brucejcooper/TinyModbus/pcb/TinyModbus.png

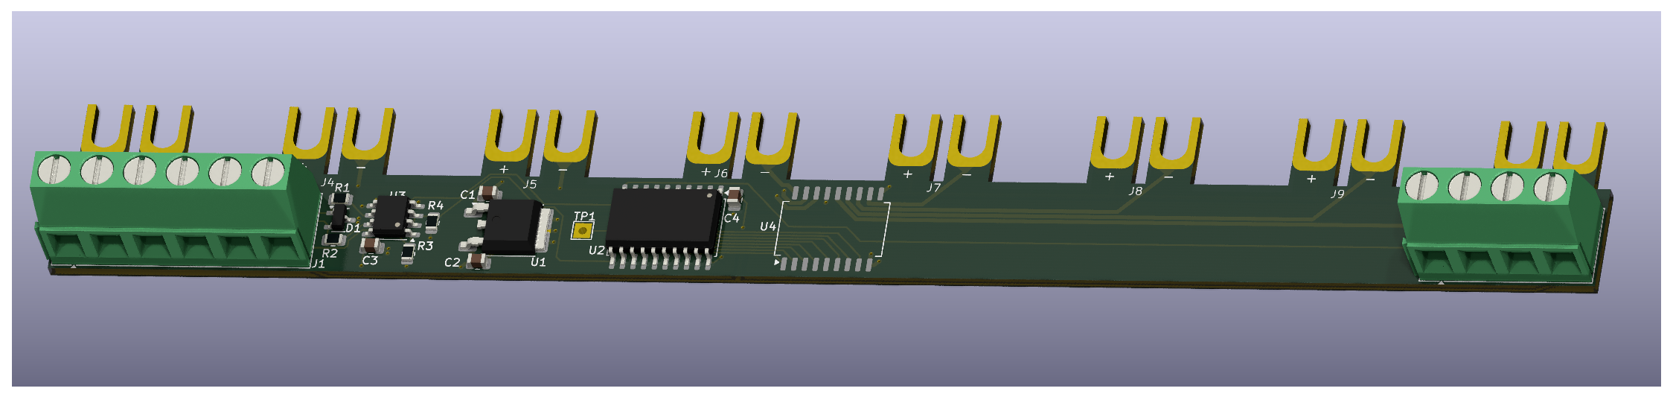
pcb/TinyModbus.png
