brucejcooper/TinyModbus/pcb/MikroeAdapter/MikroeAdapter.kicad_pcb

## KiCad design pcb/MikroeAdapter/MikroeAdapter.kicad_pcb (2026-07-29)

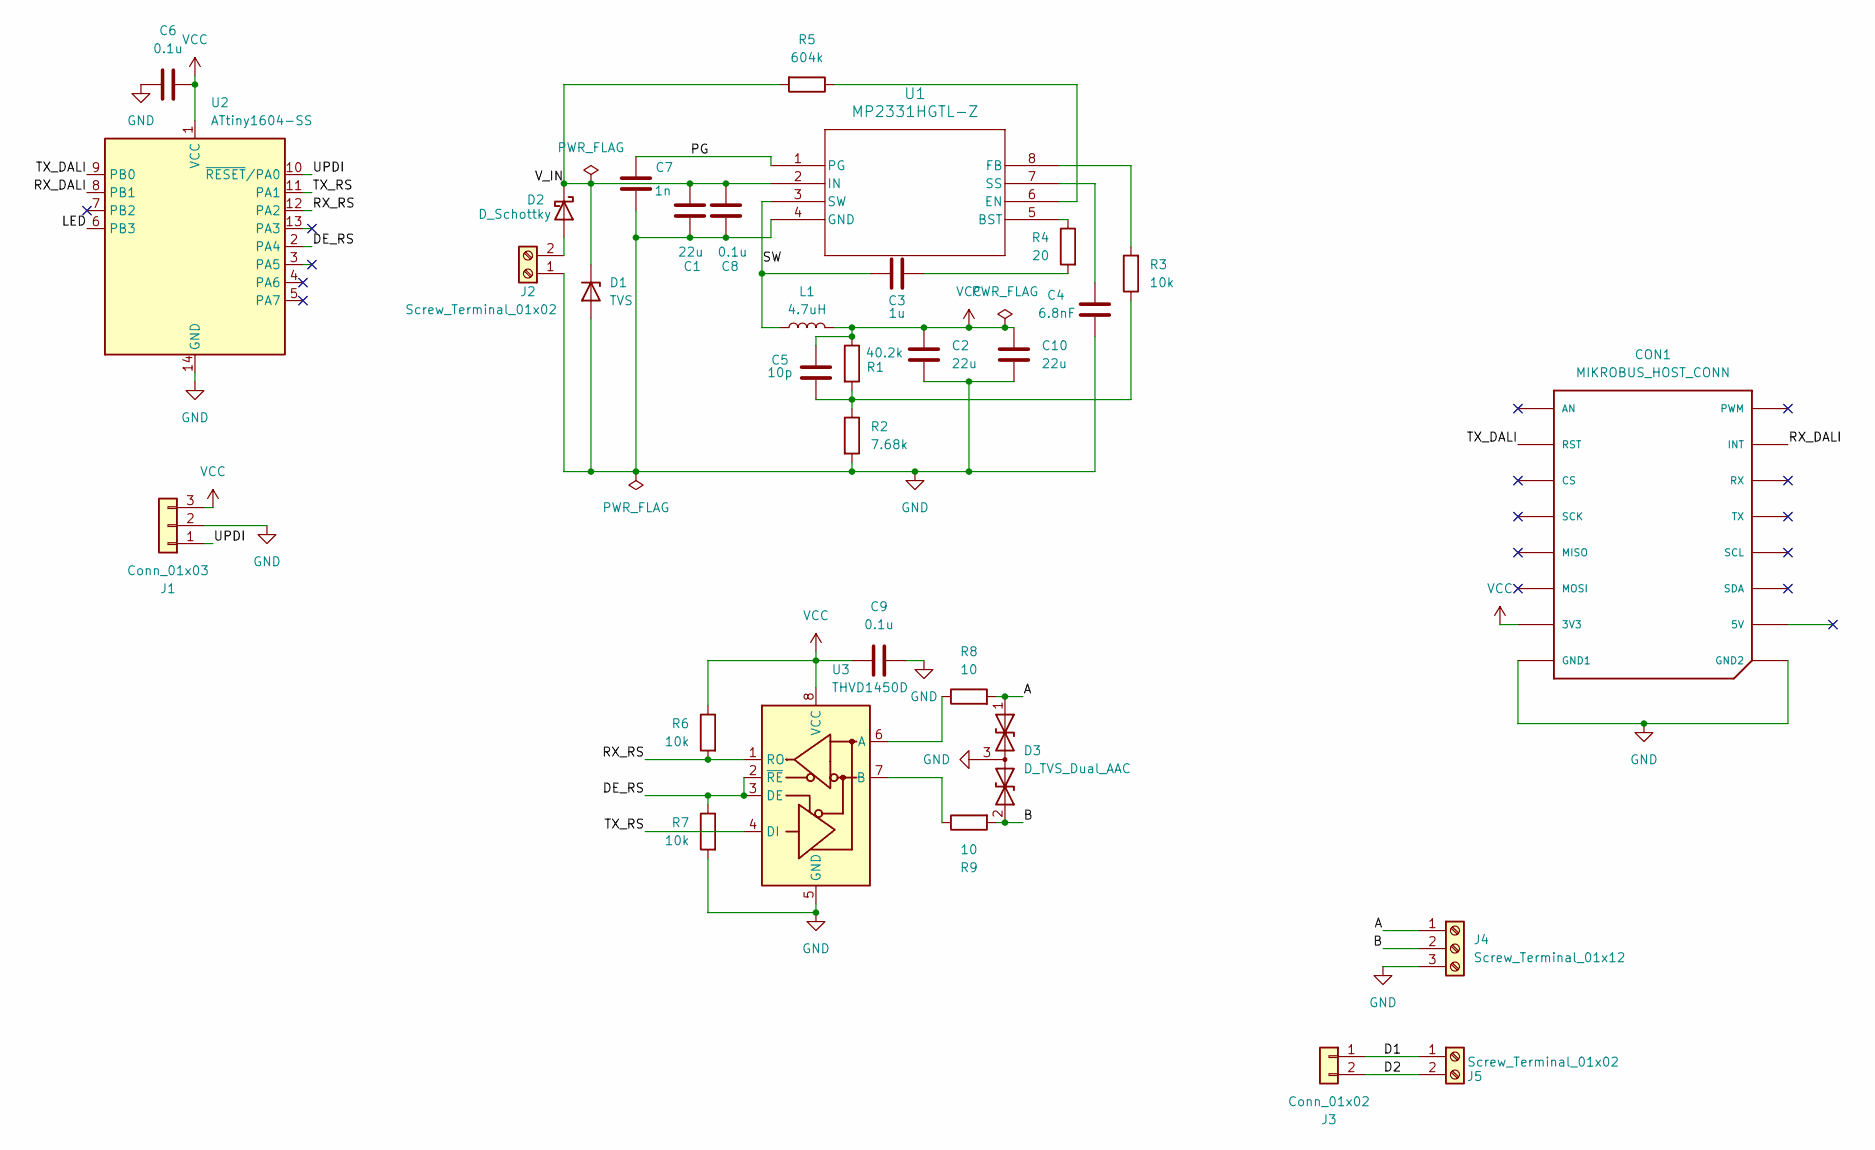
[picture p3: schematic MikroeAdapter.kicad_sch]

Parts:
C1, C2, C10: 22u; C_1210_3225Metric
C3: 1u; C_0603_1608Metric
C4: 6.8nF; C_0603_1608Metric
C5: 10p; C_0402_1005Metric
C6, C8, C9: 0.1u; C_0402_1005Metric
C7: 1n; C_0402_1005Metric
CON1: MIKROBUS_HOST_CONN
D1: TVS; D_SMB
D2: D_Schottky; D_SMA
D3: D_TVS_Dual_AAC; SOT-23
J1: Conn_01x03; PinHeader_1x03_P2.54mm_Vertical
J2, J5: Screw_Terminal_01x02; TerminalBlock_Phoenix_MKDS-1,5-2-5.08_1x02_P5.08mm_Horizont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
J3: Conn_01x02; PinHeader_1x02_P2.54mm_Vertical
J4: Screw_Terminal_01x12; TerminalBlock_Phoenix_MKDS-1,5-3-5.08_1x03_P5.08mm_Horizont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
L1: 4.7uH; IND-SMD_L4.0-W4.0_FNR40XXS
R1: 40.2k; R_0402_1005Metric
R2: 7.68k; R_0402_1005Metric
R3: 10k; R_0402_1005Metric
R4: 20; R_0402_1005Metric
R5: 604k; R_0402_1005Metric
R6, R7: 10k; R_0805_2012Metric
R8, R9: 10; R_0603_1608Metric
U1: MP2331HGTL-Z; SOT-583-8
U2: ATtiny1604-SS; SOIC-14_3.9x8.7mm_P1.27mm
U3: THVD1450D; SOIC-8_3.9x4.9mm_P1.27mm

Connections:
/A: D3.1 (A1), J4.1, R8.2
/B: D3.2 (A2), J4.2, R9.2
/D1: J3.1, J5.1
/D2: J3.2, J5.2
/DE_RS: R7.1, U2.2 (PA4), U3.2 (~RE), U3.3 (DE)
/LED: U2.6 (PB3)
/PG: C7.1, U1.1 (PG)
/RX_DALI: CON1.P15 (INT), U2.8 (PB1)
/RX_RS: R6.2, U2.12 (PA2), U3.1 (RO)
/SW: C3.2, L1.1, U1.3 (SW)
/TX_DALI: CON1.P2 (RST), U2.9 (PB0)
/TX_RS: U2.11 (PA1), U3.4 (DI)
/UPDI: J1.1, U2.10 (~RESET/PA0)
/V_IN: C1.1, C8.1, D1.1 (K), D2.1 (K), R5.2, U1.2 (IN)
GND: C1.2, C2.2, C4.1, C6.1, C7.2, C8.2, C9.1, C10.2, CON1.P8 (GND1), CON1.P9 (GND2), D1.2 (A), D3.3 (common), J1.2, J2.1, J4.3, R2.2, R7.2, U1.4 (GND), U2.14 (GND), U3.5 (GND)
unnamed: C3.1, R4.2
unnamed: C5.2, R1.2, R2.1, R3.1
unnamed: D2.2 (A), J2.2
unnamed: R4.1, U1.5 (BST)
unnamed: R5.1, U1.6 (EN)
unnamed: R3.2, U1.8 (FB)
unnamed: C4.2, U1.7 (SS)
unnamed: R8.1, U3.6 (A)
unnamed: R9.1, U3.7 (B)
VCC: C2.1, C5.1, C6.2, C9.2, C10.1, CON1.P7 (3V3), J1.3, L1.2, R1.1, R6.1, U2.1 (VCC), U3.8 (VCC)

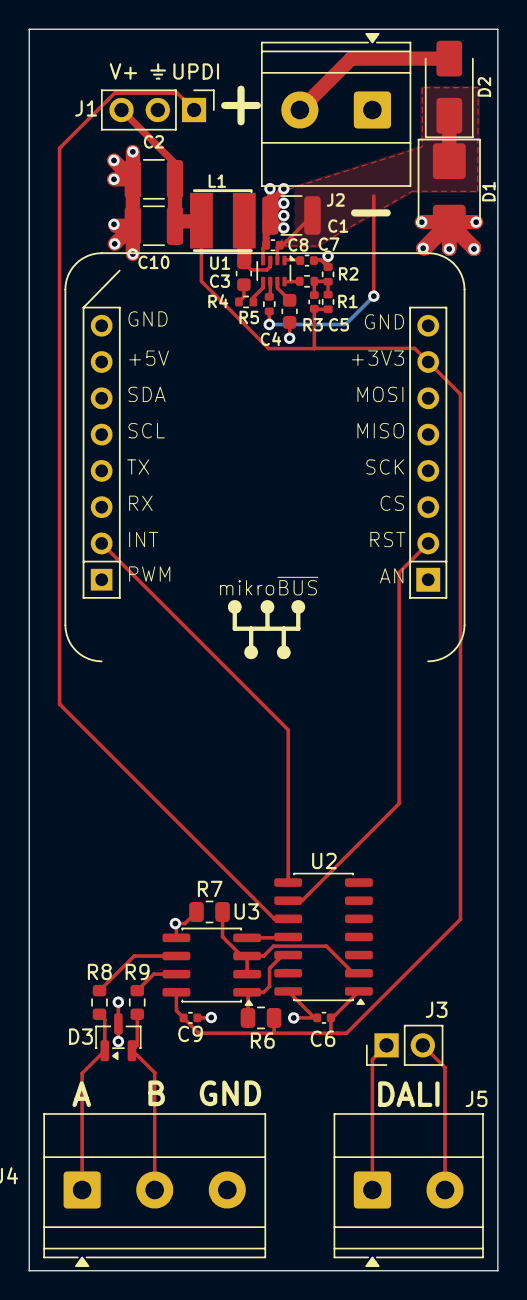
[picture p4: board MikroeAdapter.kicad_pcb from above]

Board: 2 copper layers, 32.8 x 86.9 mm, 32 parts (0 on the bottom side), 24 nets.
