brucejcooper/TinyModbus/pcb/TinyModbus.kicad_pcb

## KiCad design pcb/TinyModbus.kicad_pcb (2025-05-31)

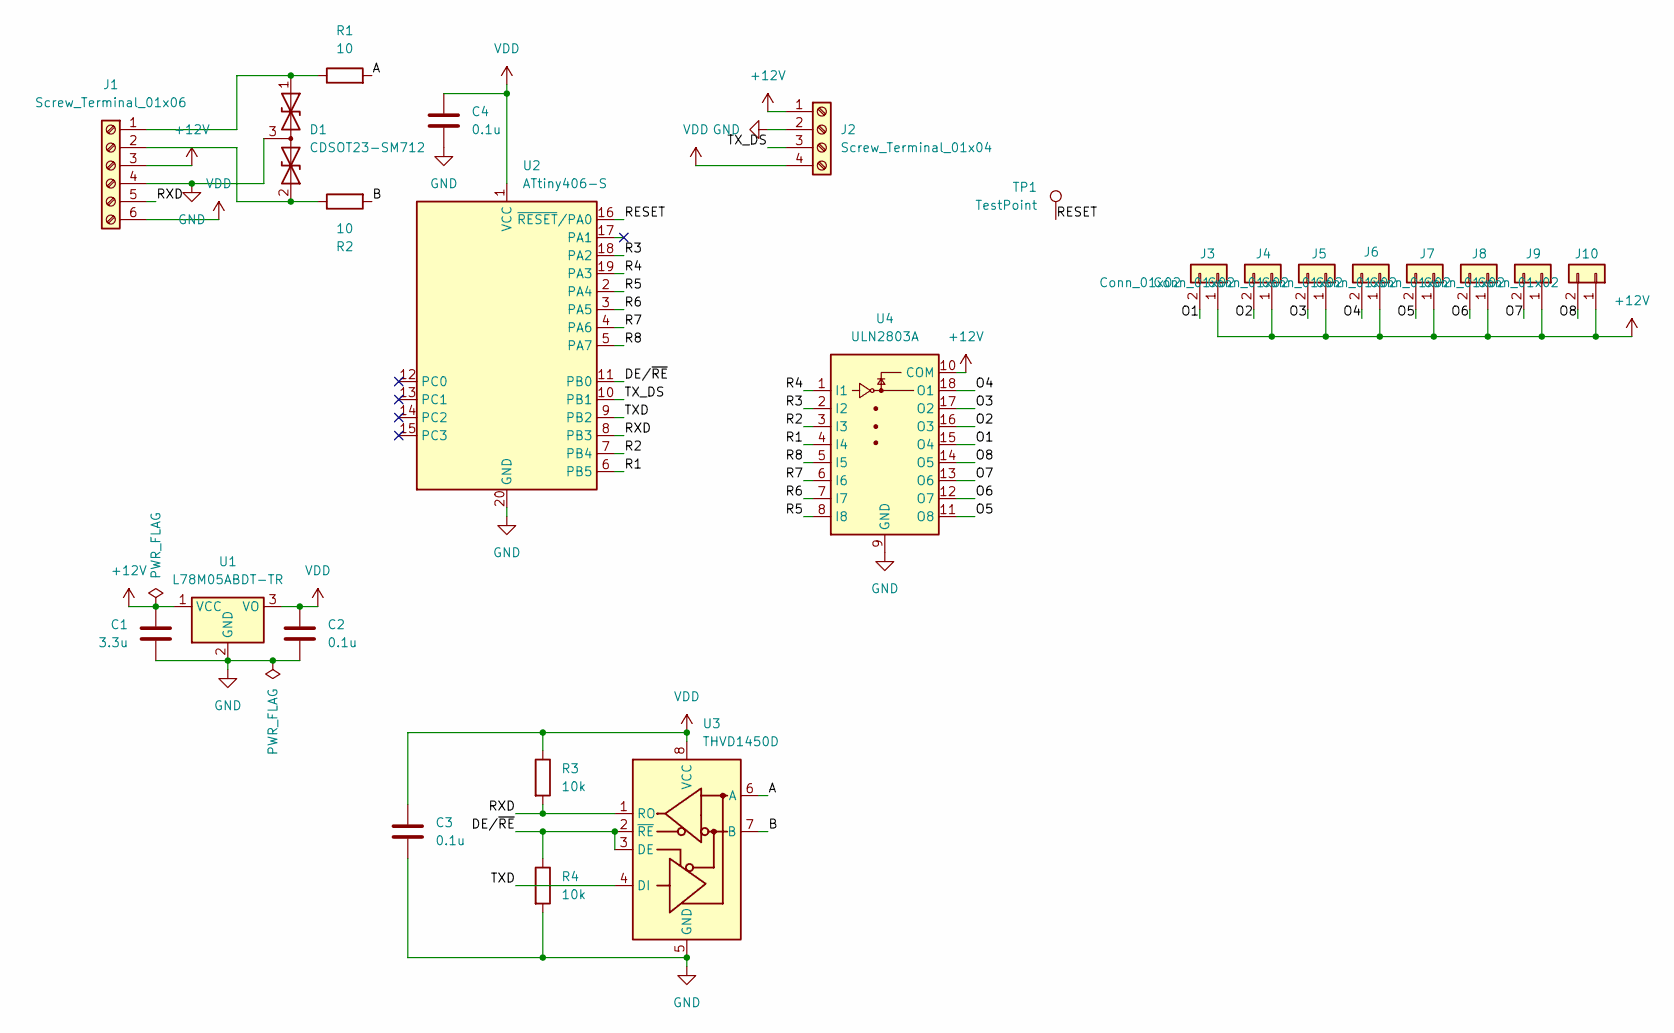
[picture p5: schematic TinyModbus.kicad_sch]

Parts:
C1: 3.3u; C_0805_2012Metric
C2, C3, C4: 0.1u; C_0805_2012Metric
D1: CDSOT23-SM712; SOT-23-3
J1: Screw_Terminal_01x06; TerminalBlock_Phoenix_MKDS-1,5-6-5.08_1x06_P5.08mm_Horizont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
J2: Screw_Terminal_01x04; TerminalBlock_Phoenix_MKDS-1,5-4-5.08_1x04_P5.08mm_Horizont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
J3, J4, J5, J6, J7, J8, J9, J10: Conn_01x02; Terminal_lug
R1, R2: 10; R_0805_2012Metric
R3, R4: 10k; R_0805_2012Metric
TP1: TestPoint; TestPoint_THTPad_2.0x2.0mm_Drill1.0mm
U1: L78M05ABDT-TR; TO-252-2
U2: ATtiny406-S; SOIC-20W_7.5x12.8mm_P1.27mm
U3: THVD1450D; SOIC-8_3.9x4.9mm_P1.27mm
U4: ULN2803A; SOP-18_7x12.5mm_P1.27mm

Connections:
+12V: C1.1, J1.3, J2.1, J3.1, J4.1, J5.1, J6.1, J7.1, J8.1, J9.1, J10.1, U1.1 (VCC), U4.10 (COM)
/A: R1.2, U3.6 (A)
/B: R2.2, U3.7 (B)
/DE/~RE: R4.1, U2.11 (PB0), U3.2 (~RE), U3.3 (DE)
/O1: J3.2, U4.15 (O4)
/O2: J4.2, U4.16 (O3)
/O3: J5.2, U4.17 (O2)
/O4: J6.2, U4.18 (O1)
/O5: J7.2, U4.11 (O8)
/O6: J8.2, U4.12 (O7)
/O7: J9.2, U4.13 (O6)
/O8: J10.2, U4.14 (O5)
/R1: U2.6 (PB5), U4.4 (I4)
/R2: U2.7 (PB4), U4.3 (I3)
/R3: U2.18 (PA2), U4.2 (I2)
/R4: U2.19 (PA3), U4.1 (I1)
/R5: U2.2 (PA4), U4.8 (I8)
/R6: U2.3 (PA5), U4.7 (I7)
/R7: U2.4 (PA6), U4.6 (I6)
/R8: U2.5 (PA7), U4.5 (I5)
/RESET: TP1.1, U2.16 (~RESET/PA0)
/RXD: J1.5, R3.2, U2.8 (PB3), U3.1 (RO)
/TXD: U2.9 (PB2), U3.4 (DI)
/TX_DS: J2.3, U2.10 (PB1)
GND: C1.2, C2.2, C3.2, C4.2, D1.3 (common), J1.4, J2.2, R4.2, U1.2 (GND), U2.20 (GND), U3.5 (GND), U4.9 (GND)
unnamed: D1.1 (A1), J1.1, R1.1
unnamed: D1.2 (A2), J1.2, R2.1
VDD: C2.1, C3.1, C4.1, J1.6, J2.4, R3.1, U1.3 (VO), U2.1 (VCC), U3.8 (VCC)

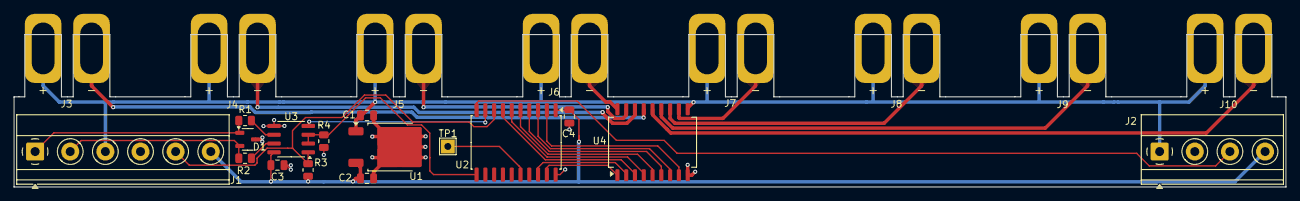
[picture p6: board TinyModbus.kicad_pcb from above]

Board: 2 copper layers, 183.9 x 22.0 mm, 24 parts (0 on the bottom side), 28 nets.
