brucejcooper/TinyModbus/src/relays.h

#ifndef __relays_H__
#define __relays_H__

#include <stdint.h>

extern void relay_init();
extern void latchOutputs();
extern void setCoil(uint8_t addr, uint8_t val);
extern uint8_t getCoils(uint8_t addr);


#endif
