brucejcooper/TinyModbus/(commit log)

2025-05-31 Added picutre of PCB
2025-10-10 Switching the name of the base to DTF08a
2025-10-15 Many bug fixes, but it now accepts DALI commands directly, as used by the web configuration device
2025-10-20 Switch to Production (hahardware, and using tick based timer, instead of trying software bollocks
2025-11-03 Fixed ISR bug, and changed web client to use entity editors, rather than just device editors that made assumptions about the entities contained
2026-04-19 Rewrite firmware with non-blocking DALI/Modbus architecture
    Replaces the synchronous rs485/timers/queue/dali_commands modules with a
    cleaner non-blocking design: a 16-entry command queue (cmd_queue), a
    dedicated register map (registers), unified tick dispatch (tick), and a
    new modbus module. FC44 retains its synchronous busy-wait behaviour for
    backwards compatibility. Also fixes the avr-gcc 7.3.0 toolchain bug where
    crtattiny1604.o defines __DATA_REGION_LENGTH__=0x400 (1KB) instead of the
    correct 0x800 (2KB), causing spurious linker overflow errors.
2026-04-19 Reduce static RAM to fit within ATtiny1604's 1KB SRAM
    - Pack cmd_type_t and reg_target_t enums (__attribute__((packed))) so each
    field is 1 byte instead of 2, saving 32 bytes in the 8-entry command queue
    - Shrink CMD_QUEUE_SIZE from 16 to 8 entries (saves 80 bytes)
    - Reduce Modbus frame buf from 136 to 72 bytes; caps FC03/FC04 reads to
    32 registers per request
    - Eliminate static ver_str[64]: version string is now built on-demand
    into buf in process_fc04 (full 32-register read only, addr 0x0200)
    - Revert erroneous __DATA_REGION_LENGTH__=0x800 Makefile workaround;
    the 1KB spec is correct for this device
    Result: Data drops from 1101 bytes to 877 bytes, leaving 147 bytes of
    headroom for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
2026-04-19 Fix DALI state machine double-dispatch and missing bus-idle wait
    cmdq_result_received() was calling dali_idle_state_enter() unconditionally,
    which started the next TX immediately. Callers then made conflicting second
    calls: timeout_waiting_for_response called dali_idle_state_enter() again
    (double-dispatch), while timer_overflow and send_rx_error called
    dali_wait_for_idle_state_enter() which overwrote the timer and undid the
    dispatch.
    Fix: cmdq_result_received() is now the single authority for post-command
    state transitions. When more commands remain it calls
    dali_wait_for_idle_state_enter() to enforce the required 22 TE bus-settling
    period before the next forward frame. When the queue empti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
2026-04-19 Add async raw DALI command registers and DTR write registers
    Register map changes:
    - 0x1000: raw DALI single send — sets FC04 0x015D to pending (0xFF00),
    result filled by callback: 0x02xx=ok, 0x01xx=nak, 0x03xx=err
    - 0x1001: raw DALI send-twice — same pending/result mechanism, NAK=normal
    - 0x1002: DAPC (shifted from 0x1001)
    - 0x1003-0x100A: action regs (shifted from 0x1002-0x1009)
    - 0x100B/0x100C/0x100D: set DTR0/DTR1/DTR2 (low byte = DTR value)
    - Writing 0x1000/0x1001 while a command is pending returns DEVICE_BUSY (0x06)
2026-04-19 Fix raw DALI command comment: two frame bytes, not addr+cmd
2026-04-19 Fix scanner queue overflow: chain per-ballast queries one at a time via callbacks
    Replaces the bulk 9-command push (which exceeded CMD_QUEUE_SIZE=8) with a
    chained callback pattern: scan_next_query pushes exactly one query per
    invocation, using a PROGMEM table and scan_query_step counter. This also
    allows the fade poller to interleave between scan commands.
2026-04-19 Replace timer-based fade poll with reactive per-ballast callback chain
    The old design fired a periodic timer and pushed 2 commands per fading
    ballast all at once, overflowing the 8-entry queue with many concurrent
    faders.
    New design: bgtasks_start_fade_poll() starts a self-sustaining
    STATUS → BRIGHTNESS → STATUS chain per ballast, guarded by a
    fade_chain_active[] bitmask to prevent duplicates. The chain pushes
    at most 2 commands at a time and terminates automatically when
    FADE_RUNNING clears.
    modbus.c calls bgtasks_start_fade_poll() for short-address DAPC and
    action commands instead of speculatively writing g_regs.fading[]. The
    fading[] register is now maintained solely by regs_apply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
2026-04-19 Remove diagnostic PB3/PA7 pin references
    pulse_led() declaration removed from dali.h (never implemented in this branch).
    PA7 pull-up (RS485_PORT.PIN7CTRL) removed from modbus_init() — was a
    diagnostic artefact from earlier firmware versions.
2026-04-19 Update README pin table: remove PB3, add signal descriptions
    PB3 (status LED) was a diagnostic pin removed from the firmware.
    Added notes on RS-485 hardware DE management and DALI RX optocoupler inversion.
2026-04-19 Bring README up to date with current implementation
    - State machine: correct variable/function names (dali_timer, cmdq_result_received, etc.)
    - Command queue: 8-entry (was 20), correct cmd_entry_t field names
    - Periodic rescan: bgtasks_trigger_scan(), 9 queries/device, ~64 s period
    - Modbus interface: replace old bank-register map with actual FC04 layout and
    MBREG_* holding register table; remove unimplemented FC01/FC05/FC0F;
    add FC10; document async raw command result register
    - FC44: marked legacy, FC06 0x1000 preferred
    - Fade tracking: document reactive chain replacing timer-based polling
    - Device address: EEPROM preferred, USERROW as fallback
    - Building: note bundled toolchain, simpl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
2026-04-19 Save 35 bytes of RAM: shift_reg uint8_t, smaller buf, remove poll_interval
    - dali_state_receiving.c: shift_reg uint32_t → uint8_t (saves 3 bytes).
    Only 8 bits are ever accumulated; the uint32_t was unnecessarily wide.
    - modbus.c: MAX_REG_RD 32→16, MAX_PKT_SZ 72→40 (saves 32 bytes).
    Version string response shortened to 16 registers (was 32); new format
    "DALI v<maj>.<min> <20-hex-serial>" fits in 31 bytes. Clients must
    read exactly 16 registers at FC04_VERSION_BLOCK (0x0200).
    - registers.c/h: poll_interval removed from register_map_t (saves 2 bytes).
    Now a module-level static; behaviour unchanged since it no longer drives
    anything. regs_set_poll_interval() removed (was unused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
2026-04-19 Repurpose poll_interval as rescan_interval (holding reg 0x1011)
    MBREG_POLL_INTERVAL → MBREG_RESCAN_INTERVAL: now controls the periodic
    bus rescan period in seconds (default 64, 0 = disabled). The RTC PIT ISR
    in bg_tasks.c reads regs_get_rescan_interval() on each 1 Hz tick rather
    than using the hardcoded RESCAN_PERIOD_S constant. rescan_counter widened
    from uint8_t to uint16_t to support values > 255.
    Writing 0 suppresses periodic rescans entirely; manual scans via
    SCAN_TRIGGER (0x1010) still work at any time.
2026-04-19 Persist rescan_interval to EEPROM; fix g_raw_resp_type init
    Reads ee_rescan_interval on boot (0xFFFF sentinel → default 64s),
    writes on FC06 update alongside slave_addr and baud_index.
    Corrects g_raw_resp_type initial value from DALI_RESPONSE_PENDING
    to DALI_RESPONSE_OK — no command is in flight at startup.
2026-04-19 Clamp rescan_counter when interval shrinks
    Without this, reducing the interval from e.g. 3600→10 left the
    counter stranded at 3500 and the new period wouldn't take effect
    for up to the old interval. The ISR clamp kicks in within 1 second.
2026-04-19 Add coils, raw cmd register updates, remove FC44 legacy command
    - FC01/FC05/FC0F: 64 Modbus coils map to ballast on/off state; coil
    writes send GOTO_LAST_ACTIVE or OFF with fade polling; FC05 supports
    non-normative 0x5500 toggle value; FC0F queues action commands before
    fade-poll STATUS queries to maintain correct ordering
    - Raw DALI commands (MBREG_RAW_CMD/MBREG_RAW_CMD_TWICE) now classify
    the transmitted frame on completion: modification commands start fade
    polling, setting commands (SET_MAX/MIN/FADE_TIME etc.) issue a
    read-back query to update the relevant holding register
    - Remove FC44 synchronous blocking DALI command; use MBREG_RAW_CMD instead
    - Remove brightness 0xFF absen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
2026-04-23 Fix timing races, queue corruption, and bus-collision hazards
    - tick.c: split --dali_timer==0 into two statements so the zero-check
    re-reads the volatile after any TCB0 preemption, preventing spurious
    timer callbacks when TCB0 fires between the decrement store and the
    comparison
    - cmd_queue.c: make cmdq_push atomic by disabling TCB0.INTCTRL (blocks
    level-1) and wrapping tail update in ATOMIC_BLOCK (blocks level-0),
    fixing a tail-pointer corruption race between main-loop and ISR pushes
    - dali_state_idle.c: check dali_is_bus_shorted() after cleanup() before
    transmitting; falls back to dali_wait_for_idle_state_enter() if the
    bus went active in the TOCTOU window between the dali_id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
2026-04-23 Update README: fix timer priorities, TRANSMITTING stop-bit behaviour, remove FC44, add coil map
    - TCA0 is level-0, TCB0 is level-1 (was reversed)
    - TRANSMITTING step 6: CMD_SEND/ARC bypass response window; only CMD_QUERY/SEND_TWICE use it
    - Remove FC44 (removed from firmware in d6a3bb6)
    - Add FC01/FC05/FC0F to function code table and coil map section
2026-04-23 Remove stale files: alternative_implementation.md and relays.h
    alternative_implementation.md was the initial design brief; the README is now authoritative.
    relays.h was defined but never included anywhere.
2026-04-23 Fix six code-review bugs and clean up minor issues
    Bugs fixed:
    - USART baud rate was hardcoded to 9600; now reads g_regs.baud_index at
    startup so EEPROM-persisted baud changes take effect after power cycle
    - Modbus silence threshold hardcoded to 1.67 ms (sub-spec); now a
    baud-rate-dependent lookup (9 / 5 / 3 TCA0 ticks for 9600/19200/38400)
    - FC0F silently dropped commands when queue was full; now checks available
    capacity atomically before the push loop and returns DEVICE_BUSY if
    insufficient, preventing partial writes
    - fade_chain_active missing volatile — ISR/main-loop race on the 4×uint16_t
    fade-tracking bitmask
    - DALI_RESPONSE_COLLISION was a dead enum value that made the e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
2026-04-27 Fix atomic protection, silent queue drops, FC10 partial execution, and minor issues
    - bgtasks_start_fade_poll: volatile alone doesn't prevent ISR preempting the
    16-bit R-M-W on fade_chain_active; wrap check-and-set and cleanup in
    ATOMIC_BLOCK so the bit state is never torn between ISR and main loop
    - dispatch_action_reg (DAPC, DTR, action regs): check cmdq_push_* return and
    propagate MB_ERR_DEVICE_BUSY instead of silently dropping DALI commands
    - process_fc05: same — check cmdq_push_cmd and return DEVICE_BUSY on failure
    - process_fc10: pre-flight pass counts required queue slots and checks raw-cmd
    pending state before touching any register or queue entry, preventing partial
    execu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
2026-04-29 Address fresh-scan findings: power-on readback, WDT race, ISR flag handling
    dali_set_power_on_level now reads back GET_POWER_ON_LEVEL instead of
    GET_POWER_FAIL_LEVEL (copy-paste bug; cache for power-on level was never
    refreshed by the helper).
    WDT setup moved before sei() so the _PROTECTED_WRITE OUT/STS pair can't be
    split by an ISR — an ISR firing in the 1-cycle gap between the two would
    have blown past the 4-cycle CCP protection window and silently dropped the
    WDT arm.
    processSetSingleHoldingRegisterCommand wraps each 16-bit shortVal cache
    write in ATOMIC_BLOCK so a TCA0 ISR doing a byte write to the same register
    can't tear it. The GROUPS_BANK diff also reads the cached value atomical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
2026-04-29 Add -fstack-usage; rename dali_rx_rising_callback → dali_rx_callback
    The variable held the handler for both rising-edge and level-low one-shot
    RX interrupts; the old name implied only the former. Renamed for clarity.
    -fstack-usage now emits per-function .su files in build/ on each compile,
    so future changes that deepen a frame are visible. Worst-case nested-ISR
    stack measured at ~100 B (main → set_min_level → queue_command → tx_enter,
    preempted by USART_RXC, preempted by TCA0 LVL1 running the full receive-
    timeout chain through scan_result_received). README updated with the
    measurement and the path to re-derive it.
2026-04-29 Atomic daliResponseType + RX FIFO drain
    dali_response_type_t enum renumbered so all values fit in uint8_t (0..6,
    16..31 for SHORT, 0xFF for PENDING — preserving the arithmetic in
    dali_response_to_err). The daliResponseType variable is stored as uint8_t
    so reads and writes are single-instruction atomic. The previous int-sized
    storage could tear between PENDING (0x00FF) and any value with a non-zero
    high byte (e.g. NAK = 0x0194), occasionally producing a transient value
    that matched no enum case and surfaced as a spurious illegal-function
    exception to the Modbus master.
    USART0_TXC_vect now drains the RX FIFO before re-enabling RXCIE. Bytes
    the master sent during our transmission accumulate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
2026-04-29 Protect 16-bit function-pointer reads from LVL1 preemption
    PORTB_PORT_vect (LVL0) reads dali_rx_callback, a 16-bit function pointer
    that TCA0 LVL1 callback chains rewrite via dali_call_on_rising_once /
    dali_call_on_low_once. If LVL1 lands between the two LDS instructions of
    the LVL0 read, the reconstructed pointer is a torn old/new mix and the
    subsequent call lands on a garbage address. Snapshot the pointer inside
    ATOMIC_BLOCK before calling.
    dali_state_receiving_enter is reached from the same PORT_vect chain while
    daliTimer is still mid-countdown from dali_wait_for_response_state_enter.
    The two STS instructions for daliTimerCallback can be split by TCA0 LVL1
    firing at the moment daliTimer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
2026-04-29 Atomic protection for daliTimerCallback and post_cmd_callback writes
    Three more LVL0-context paths write 16-bit function pointers in two
    non-atomic STS instructions while a higher-priority ISR can read them:
    - dali_state_receiving_enter rewrites daliTimerCallback while daliTimer is
    still mid-countdown from dali_wait_for_response_state_enter; if TCA0 LVL1
    fires between the two STS and the timer reaches zero in the same cycle,
    the dispatched callback is a torn pointer. (Fixed previously by zeroing
    daliTimer first; verified again here.)
    - onBusShorted and onIdleBus in dali_state_wait_for_idle.c rewrite
    daliTimerCallback when called from PORTB_PORT_vect (LVL0) while the
    previous sta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
2026-04-29 Tighten torn-pointer protection in onBusShorted/onIdleBus
    Last pass moved the daliTimer = 0 zeroing between dali_call_on_X_once and
    the daliTimerCallback assignment. That protected the daliTimerCallback
    write but missed an earlier window: dali_call_on_X_once itself contains a
    two-STS write to dali_rx_callback, which can also be torn if TCA0 LVL1
    fires the (still-armed) old daliTimerCallback during the helper.
    Move daliTimer = 0 to the very start of both onBusShorted and onIdleBus so
    the dispatch is suppressed before either of the two pointer writes
    (dali_rx_callback inside the helper, then daliTimerCallback) begins.
2026-04-29 Prevent uint16_t wrap in addr+count bound checks
    The four read-side handlers (processGetCoilsCommand, sendHoldingRegs,
    sendInfo, processSetCoilsCommand) all checked addr+count against a small
    upper bound (DALI_MAX_DEVICES, DALI_MAX_HOLDING_REGISTER, strRegs) using
    uint16_t arithmetic. Both addr and count come straight from the Modbus
    frame as 16-bit values, so addr=65535 and a non-zero count cause the
    addition to wrap inside uint16_t to a small value that passes the bound
    check. The handlers then proceed:
    - processGetCoilsCommand reads dali_holding_regs[65535+] (out of bounds).
    - sendHoldingRegs sets streamSrc past the end of dali_holding_regs and
    the streaming TX reads garbage memory.
    -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
2026-04-29 Cleanup: defer pointer arithmetic past bound check; memmove for overlap
    Two formal-correctness cleanups uncovered by the latest scan:
    - processGetCoilsCommand was forming the sptr pointer (= base + addr)
    before the bound check on addr+count. Forming a pointer more than one
    past an array's end is UB in C even if never dereferenced; reorder so
    the pointer arithmetic happens after the validation.
    - process_command_response's queue compaction uses memcpy on overlapping
    regions (commandQ vs commandQ+1). avr-libc's memcpy happens to be a
    forward copy (which is safe in this direction), but the C standard
    treats overlapping memcpy as UB. Switch to memmove.
    Both are zero-risk changes wi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
2026-04-29 Protocol-compliance fixes from multi-agent review
    Fixes (Modbus + DALI compliance review):
    - Modbus §2.4.1 broadcast suppression. inputIsValidModbusCommand now
    records whether the accepted request was a broadcast (deviceId 0); the
    shared sendResponse and sendError paths check this flag and skip the
    actual transmission, instead resetting state and re-arming RX. Without
    this, multiple slaves on a multi-drop bus would all reply on every
    broadcast and collide.
    - Modbus §6.5 0x05 (Write Single Coil) value validation. Spec mandates
    0xFF00 (ON) or 0x0000 (OFF) only; the firmware retains the non-standard
    0x55xx toggle extension (matched by high byte) and now rejects all
    other valu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
2026-04-29 Add Modbus §2.5.1.1 initial-silence gate on RX
    After reset (power-on or WDT) the slave must observe 3.5 character times
    of bus silence before accepting bytes as the start of a new frame —
    otherwise we'd latch onto whatever byte position the master happens to
    be sending if it was mid-frame at reset time, fail CRC, and waste bus
    time on the next inter-byte timeout cycle.
    New static volatile flag initial_silence_observed, false at boot. While
    clear, the RXC ISR drains incoming bytes (resetting rs485Timer to 10
    ticks ≈ 3.75-4.17 ms each time a byte/SFD arrives) but does not
    accumulate them into the frame buffer. When rs485Timer_timeout fires
    without an intervening byte, 3.5 char of silence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
2026-05-03 Subtask 1: defensive fixes - DALI TX OUTCLR + BOD fuse
    - dali_idle_state_enter(): OUTCLR DALI TX as first action
    (belt-and-braces against glitched paths leaving the bus driven).
    - timeout_waiting_for_response(): same OUTCLR before yielding to idle.
    - main.c: emit FUSES record with BODCFG=0x44 (BOD active mode at >=2.6V);
    other fuses at factory defaults.
    - Makefile: drop \`-R .fuse\` from avr-objcopy so the .fuse segment makes
    it into main.hex and pymcuprog actually programs the fuse byte.
    Build clean. Program 14338 (+22 from baseline 14316), Data 849
    (unchanged from baseline).
2026-05-03 Subtask 3: dali_sync skeleton + sync_flags table + PIT cursor
    Add the new dali_sync module that will replace the cmd_queue + bg_tasks
    pair in subtask 5. This subtask only adds data structures, atomic
    helpers, and stubs; subtask 4 wires up the unified DALI issuance path
    and the work selector that consumes sync_flags[].
    New files:
    - src/dali_sync.h - SYNC_READ_*, SYNC_WRITE_*, SYNC_RETRY_PENDING bit
    definitions; extern declarations of sync_flags[64], dali_busy,
    current_op{addr,op,step}, group_write{reg_addr,pending_adds,
    pending_removes}; static-inline atomic helpers sync_flags_set /
    sync_flags_clear (ATOMIC_BLOCK with ATOMIC_RESTORESTATE so they are
    safe from any context); prototy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
2026-05-03 Subtask 2: per-ballast banks FC04 -> FC03 (read+write stubs)
    Move the four per-ballast banks (0x0000-0x00FF) and group membership
    masks (0x0110-0x014F) from FC04 input registers (read-only) to FC03/
    FC06/FC10 holding registers (read-write). Same address space, same
    byte ordering as the previous FC04 layout - register_map_t bytes have
    not moved, only the access path has changed.
    This is an intentional breaking change for any master that read these
    banks via FC04 (confirmed acceptable by the user). After this commit:
    - FC03 reads of 0x0000-0x00FF return the cached
    status|brightness, min|max, power_on|sys_fail, fade_rate|fade_time
    pairs by direct offset into g_regs (no extra storage).
    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
2026-05-03 Subtask 4 fixup: reviewer P1 — collapse cursors + relax group BUSY
    Two of reviewer-4's P1 items addressed:
    1. **Single rotating work cursor** (was: separate read_cursor + write_cursor).
    Per spec ("walk sync_flags from the rotating cursor" — singular) and
    reviewer's design-review point 2. The cursor advances on every
    issued command (write or read) so high-numbered ballasts can't be
    starved by continuous low-numbered work, regardless of which
    priority slot serviced them. Saves 1 byte data and removes the
    "what if writes always start at a different cursor than reads"
    question.
    2. **No-op group writes ACK during a busy group channel.** Master
    writing a group regi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
2026-05-03 Subtask 5: physically delete queue/bg_tasks, retire coil + action-reg API
    Cleanup pass: remove the now-vestigial code subtask 4 left routed through
    dali_sync_arm_raw, and physically delete the legacy subsystems. By the
    end the codebase is fully on the flag-driven model with no dead queue
    code present.
    Files deleted (-437 lines):
    src/cmd_queue.c, src/cmd_queue.h, src/bg_tasks.c, src/bg_tasks.h
    Modbus surface changes (BREAKING — masters need to switch):
    - FC01 / FC05 / FC0F coils retired entirely. Frames using these
    function codes survive frame_is_valid (size-table entries kept) and
    fall through to modbus_process's default branch which returns
    ILLEGAL_FUNCTION. Per-balla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
2026-05-03 Subtask 6: final README pass + verification + move task to done/
    Wraps up the flag-driven refactor (task #1). Documentation-only edits
    plus housekeeping; no source-code changes in this commit.
    README changes
    --------------
    - New top-level "## Architectural Model" section placed immediately
    before "## DALI State Machine". Four paragraphs explaining the
    flag-driven state-reconciliation loop, the priority-chain work
    selector, the unified issuance chokepoint with cache-invalidation as
    a property of the command bytes, and the "no queue / no
    event-callback chain" closer.
    - "DALI State Machine" intro reworded: "background scan" -> "PIT-driven
    sync-flag cursor". ASCII state diagram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
2026-05-03 Subtask 7: post-merge polish (classify simplification + atomic discipline + scan short-circuit)
    Five focused changes identified during the user's manual review of the
    merged refactor (branch tip d1c7ed2 / tag task-1-complete).
    1. Collapse classify_invalidation in dali_sync.c from an 8-branch range
    table to 4 branches: DAPC / data<0x20 / data==0x20 / data<0x90 / else.
    Trade-off: 0x21 STORE_CURRENT_LEVEL_DTR0 plus reserved opcodes in the
    0x22-0x29, 0x30-0x3F and 0x81-0x8F bands now over-invalidate (trigger
    one extra background scan); user-approved as "we don't need to be
    perfect", and the simpler classifier is easier to maintain than an
    exhaustive opcode table.
    2. Use sync_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
2026-05-03 Outcome appendix: reflect subtask 7 polish + move task-1-complete forward
    The Outcome section originally captured subtasks 1-6 and pinned
    task-1-complete at d1c7ed2. Subtask 7 (post-merge polish, ae30a84)
    landed after the user's review and is also part of task #1, so:
    - Sub-task summary table: subtask 6 row is now d1c7ed2 explicitly;
    added subtask 7 row capturing classify_invalidation simplification,
    atomic-helper consistency, OP_FULL_SCAN short-circuit on NAK, the
    unused reg_off cleanup, README documentation, and the noinline /
    noclone measurement (kept; +480 B regression without).
    - Final binary sizes table: 3-column Baseline / Subtask 6 / Final.
    Final is 13754 / 851; +20 flash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
2026-05-03 Outcome appendix: reflect subtask 8 + advance task-1-complete
    Subtask 8 (719b8f8 FC04 trim) landed after the user's second post-merge
    review. Updates:
    - Sub-task summary table: subtask 7 row now ae30a84 explicitly; new
    subtask 8 row capturing the fading / group_status / scan_status
    removal and the 0x0100-0x0108 contiguous ladder for present /
    dirty / raw_cmd_result, with the padding-hole rationale.
    - Final binary sizes table: 4-column Baseline / Subtask 6 / Subtask 7 /
    Final. Final at 13252 / 823 — net -1064 B Program (-7.4%) and
    -26 B Data (-3.1%) versus the pre-refactor baseline. Surprise -502 B
    Program in subtask 8 traced to gc-sections dropping the now-unused
    64-itera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
2026-05-04 Subtask 9: remove MBREG_SET_DTR0/1/2 (-212 B program)
    The three DTR-setter holding registers (0x100B/0x100C/0x100D) were
    thin wrappers around `dali_sync_arm_raw` — the master can achieve the
    same effect by issuing the corresponding special DALI command via the
    raw channel: write 0xA3VV to 0x1000 to load DTR0 with VV (likewise
    0xC3VV for DTR1, 0xC5VV for DTR2). Removing them deletes a duplicate
    dispatch path and tightens the FC10 raw-arming pre-flight check.
    Removed:
    - MBREG_SET_DTR0/1/2 defines (registers.h).
    - Two switch cases in regs_read_holding / regs_write_holding
    (registers.c) that used to ACK these addresses.
    - The DTR branch in dispatch_action_reg (modbus.c).
    - DALI_ADDR_SET_DTR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
2026-05-10 Doc cleanup: timeless comments, README phrasing, modernise test.py
    Mechanical sweep of stale subtask references in inline source comments
    and one phrasing nit in README:
    - src/dali_state_idle.c — strip "subtask 4+ / subtask 5 renames it"
    paragraph; rephrased as a present-tense description of the dispatch
    fan-in. Also drops the unused "registers.h" include (file uses
    only dali.h + dali_sync.h symbols; clangd flagged it).
    - src/registers.h — drop "after subtask 5" qualifier on the raw-cmd
    comment block; describes the current state directly.
    - src/modbus.c (3 sites) — strip "after subtask 8" / "after subtask 9"
    / "retired in subtask 5" phrasings. Each comment block now reads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
2026-05-10 Task 2: DALI commissioning (control gear, IEC 62386-102)
    Add bisect-based discovery + addressing: master writes 0x1014 with
    0x0001 (full) or 0x0002 (incremental) to trigger commissioning, polls
    the same register for status with read-clears semantics on terminal
    states (0x02XX complete / 0x03XX error). Out of scope: 24-bit forward
    frames, memory-bank reads, DT1/DT8 extensions.
    What lands:
    - dali.h: TERMINATE / INITIALISE / RANDOMISE / COMPARE / WITHDRAW /
    SEARCHADDR_H/M/L / PROGRAM_SHORT_ADDRESS / VERIFY_SHORT_ADDRESS /
    QUERY_SHORT_ADDRESS opcodes + DALI_INIT_DATA_* + DALI_PROG_SHORT().
    - dali_sync.{c,h}: OP_COMMISSION work-selector slot (highest
    priority — beats raw, othe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
2026-05-10 Task 2 outcome appendix; move spec to done/, advance task-1-complete
    Doc-trail companion to commit 5c9ee70 (DALI commissioning). Same
    pattern as task 1's per-subtask Outcome appendix updates: the spec
    file was untracked while the task was active, now moves to
    tasks/done/ with an Outcome section appended in-place.
    Outcome section captures:
    - The implementation surface (opcodes, work-selector slot, phase
    machine, Modbus register, cache integration) in a one-row-per-area
    table.
    - Final sizes: Program 13040 -> 14350 (+1310; +310 over the +1000
    task-spec target), Data 823 -> 835 (+12; under +27). Chip
    headroom: 2028 B Program, 189 B Data. Stack high-water unchanged
    at 49 B.
    - Cuts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
2026-05-10 Add DALI implementation comparison report
    Research artefact written during task 1 / task 2 review. 866 lines,
    inventories TinyModbus vs:
    - IEC 62386-101/-102 (DALI v1) and DALI-2 ed.2 spec coverage
    - IEC 62386 device-type extensions (DT0-DT8+, D4i parts 250-253)
    - Open-source AVR / ESP32 / Cortex-M / Python DALI libraries
    (python-dali, hubsif/arduino-dali, paultbarrett/bitsDALI,
    Spectoda, ESPEnlightDALI, Tasmota, edinburghhacklab/dali, ...)
    - Commercial Modbus-DALI gateways (Lunatone DALI 4Net / IoT4,
    Domat R091, Intesis MBS-DAL, Helvar 436, Loytec L-DALI)
    - Vendor application notes (Microchip AN1487, Silicon Labs
    AN1220, TI MSPM0, Beckhoff InfoSys)
    Output:
    - Section A — IEC 62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
2026-05-10 Task 3: commissioning fix-ups (bisect bug + bus-stuck + doc cleanups)
    - P0-1 (dali_sync.{c,h}): commissioning bisect at bb==0 NO no longer
    issues PROGRAM against a stale gear-side SEARCHADDR. New
    resend_pending flag set in COM_COMPARE; new explicit COM_SEARCH_L
    completion case routes to COM_PROGRAM_ADDR after the corrected
    SEARCHADDR has been pushed to the gears, then clears the flag.
    Affected ~50% of bisect rounds (random addresses with bit 0 = 1)
    and tripped COMM_STATUS_ERR_VERIFY_FAIL on real-bus runs of >6
    ballasts.
    - P1-1 (dali_state_wait_for_idle.c): bus_stuck_timeout now clears
    dali_busy + current_op and, for in-flight commissioning, stamps
    COMM_STATUS_ERR_BUS_STUCK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
2026-05-11 Task 4: TX-asserted watchdog + polarity documentation
    Defensive hardening pass from the TX-stuck safety audit
    (tasks/tx-safety-audit.md). No bugs being fixed — pure defence-in-depth
    plus comment clarifications.
    1. src/tick.c: TX-asserted watchdog in TCA0_OVF_vect. After dali_tick()
    runs, check (DALI_PORT.IN & DALI_TX_bm) && dali_timer == 0u; if both
    are true the bit-level state machine has stalled with PB0 asserted
    and no pending callback, so force OUTCLR DALI_TX_bm to release the
    bus. Cannot fire during normal TX: every OUTSET in send_one is
    paired with dali_timer = 1, so the guard observes dali_timer != 0
    on every post-tick check. Action is minimal — only releases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
2026-05-11 Task 4 outcome appendix; move spec to done/, advance task-1-complete
    Doc-trail companion to commit 81b14d9 (TX safety hardening: watchdog +
    polarity documentation). Same shape as task 1 / 2 / 3 appendices:
    the spec file was untracked while the task was active and now moves
    into tasks/done/ with an Outcome section appended in-place.
    Outcome captures:
    - The five fixes table: P2-1 watchdog + P1-A datasheet note + P2-2
    stale comment + P2-3 polarity invariant + D1 README pin-table.
    - Final sizes: Program 14440 -> 14462 (+22), Data unchanged. Within
    the +30 / +0 budget. Net vs pre-task-1 baseline 4c2888b: +146 B
    Program (+1.0 %), -13 B Data (-1.5 %). Stack high-water 49 B
    unchanged.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
2026-05-11 Add code-review and TX-safety-audit reports
    Two research artefacts written during the post-merge review phase.
    Companions to dali-comparison-report.md (commit 9b5bc38).
    - tasks/code-review-report.md (569 lines) — whole-codebase code
    review after task 2 landed. Surface: 1 P0, 6 P1, 8 P2, 3 P3
    findings. Drove task 3 (commit 5550006), which fixed the P0
    commissioning bisect bug + P1 bus-stuck loop + three P2 doc bugs.
    The five other P1 findings were verified safe and explicitly
    flagged as such; future maintainers should not re-investigate.
    - tasks/tx-safety-audit.md (410 lines) — focused safety audit of
    PB0 (DALI TX) bus-stuck failure modes after task 3. Surface:
    0 P0, 2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
2026-05-15 Doc alignment pass against flag-driven firmware
    README:
    - Address-byte broadcast row: fix 7-bit typo, split DAPC/cmd via A0=0/1.
    - Standard-commands table: separate STEP_UP/STEP_DOWN from UP/DOWN
    (fade-rate vs immediate-step, per IEC 62386-102).
    - Connection paragraph: drop the stale EEPROM/USERROW-fallback story; all
    three persisted-config values live in USERROW now, runtime baud/slave
    switch is deferred until the response clears the wire.
    - Work-selector priority chain (sync-flag section): add commissioning at
    the top to match pick_work().
    - FC10-holes limitation: add the 0x100B-0x100D (SET_DTR retired in
    subtask 9) and 0x0100-0x010F (FC04-only range) gaps.
    - Drop the "WAIT_FOR_I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
2026-05-16 Hold off DALI traffic for 1 s after reset
    ATtiny1604 finishes its own startup well before DALI ballasts on the
    same supply rail are ready to respond. Without a wait, the initial
    SYNC_READ_FULL sweep that main() arms after sei() races the ballasts
    and marks slow starters absent; they only get re-discovered later by
    the RTC PIT rescan cursor at the configured rescan interval.
    Add _delay_ms(1000) immediately after the clock switch (so the delay
    is calibrated against F_CPU = 10 MHz, not the default 3.33 MHz start
    clock). DE is already driven low above the clock setup, so RS-485 TX
    stays muted across the wait.
2026-06-05 Fix Modbus RX starvation from interrupt-disabled pick_work() scan
    start_next_dali_work() ran pick_work() — a scan of up to ~192 ballast
    flag entries — inside a global ATOMIC_BLOCK. On every idle main-loop
    pass this held ALL interrupts off for hundreds of microseconds,
    overflowing the USART's 2-byte RX FIFO and silently dropping ~25% of
    incoming Modbus bytes. Every frame then failed CRC, so the gateway went
    deaf to Modbus whenever the DALI side was idle. A running DALI scan sets
    dali_busy, which gates this call out — masking the bug, which is why it
    "worked during a scan" and on units whose DALI bus never went idle.
    Move the long pick_work() scan out of the global-interrupt-off region.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
2026-06-05 Add MBREG_SYSTEM_RESET software-reset register (0x1015)
    Write the magic 0xA5A5 to 0x1015 to force a software reset of the gateway
    once the Modbus ACK has cleared the wire (deferred via the TXC ISR;
    RSTCTRL.SWRR under _PROTECTED_WRITE). Any other value is ILLEGAL_ADDRESS.
    Recovery hatch for the controller's `gw_reboot <slave>` command.
2026-06-05 README: point hero image at the Mikroe adapter PCB render
2026-06-05 PCB: migrate from TinyModbus board to the MikroeAdapter board
2026-06-06 Fix present[] bitmask byte order in FC04 read (was little-endian on wire)
    present[0..3] are uint16_t set with bit ops, then shipped via the bulk
    regs_read_input_bulk memcpy — which copies AVR little-endian memory, so a
    present bit for short address N (N<8) went on the wire byte-swapped and the
    big-endian master read it shifted by 8 (ballast at addr 0 reported at 8, 1
    at 9, …). Re-emit each present word big-endian in process_fc04, the same
    fix-up dirty[] and raw_cmd_result already have (TCB0-fenced so the 16-bit
    reads can't tear against the LVL1 completion handler).
    Confirmed on the wire (response reg0 bytes 03 00 -> now 00 03) and end to
    end: `show present 2` reports 0 1 instead of 8 9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
2026-06-06 Add RX error counters + last-failed-frame capture (FC04 0x0300)
    Diagnostics to distinguish RX failure modes without guessing: rx_overflow
    (USART FIFO overflow = byte lost), frame_error (USART framing/parity),
    crc_error (full frame arrived but CRC != 0; foreign-slave frames excluded),
    frames_ok (denominator), and the bytes of the last CRC-failed frame. Read
    via a 16-register FC04 read at 0x0300.
    These pinned down the "semi-frequent timeout under DALI load" as RX byte
    mis-sampling at 38400 (rx_overflow stayed 0; crc_error/frame_error rose 1:1
    with the timeouts; the wire was clean per the Saleae) — i.e. the ATtiny's
    internal-RC-oscillator RX margin, not FIFO starvation.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
2026-06-06 configure: default BAUD_INDEX back to 1 (19200)
    38400 is marginal for the ATtiny internal-RC-oscillator RX sampling — under
    load it mis-frames bytes and fails CRC (clean on the wire, confirmed on the
    Saleae). 19200 doubles the bit-time margin and runs error-free, so it is the
    canonical bus baud again.
2026-06-06 Add commissioning mode 3: re-provision the gear at one short address
    Write 0x03YY to MBREG_COMMISSION to re-address only the control gear currently
    at short address YY (0..63) onto the lowest free addresses — the fix for a
    short-address collision (e.g. several new ballasts pre-set to 0) without
    disturbing any correctly-addressed gear. Reuses the existing
    INITIALISE->RANDOMISE->search->PROGRAM->VERIFY->WITHDRAW state machine; the
    only additions are the INITIALISE data byte ((YY<<1)|1 = "gear at YY") and a
    target-address field. Completion already routes non-full modes through
    com_lowest_unused, so assignment is shared with incremental mode.
    Validated on hardware: a deliberately-created co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
2026-06-06 PCB: add AVR32DD14 sym-lib-table; gitignore KiCad autosave/lock files
2026-06-07 dali_sync: re-read level until the fade settles so HA gets the real state
    A level-changing command (GOTO_LAST_ACTIVE, fade up/down) was re-queried exactly
    once — mid-fade — so the settled level was never captured, and the single dirty
    pulse raced the controller's poll window (especially multi-target) and was missed.
    OP_LEVEL_READ now keeps SYNC_READ_LEVEL set while QUERY_STATUS reports FADE_RUNNING,
    re-reading until the level settles and dirtying each change. The dirty bit stays
    set for the whole fade, so the controller reliably catches it and tracks to the
    final value.
    Verified on the rig: multi-target button ON 2/8 → 8/8 with a fade, and `on` now
    reports the actual settled level (1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
2026-06-07 dali_sync: poll level until valid AND settled (fixes 255 after GOTO_LAST_ACTIVE)
    Wire-proven on the DALI bus (Saleae, Manchester-decoded; forward frames validated
    against the known opcodes): after GOTO_LAST_ACTIVE a ballast answers QUERY ACTUAL
    LEVEL with 0xFF (DALI MASK / "level not available") for the brief window before the
    fade starts — status still 0x00 (not fading) — then flips to FADING (0x14) and real
    ramping levels. The old OP_LEVEL_READ read that single 0xFF, saw not-fading, stopped,
    and stored 255, which propagated all the way to HA as 100%.
    OP_LEVEL_READ is the ONE path every level-changing command funnels into (DAPC, OFF,
    UP, DOWN, GOTO_LAST_ACTIVE, RECALL_MAX all set SYNC_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
2026-06-09 fix(modbus): make frame completion spec-compliant — wait for t3.5 silence
    The RXC ISR had a fast-path that marked a frame ready (and disabled RX)
    immediately on the last byte once CRC checked out, without waiting for the
    3.5-char inter-frame silence Modbus §2.5.1.1 requires — contradicting
    modbus_process's own comment, which states frame_ready is gated on t3.5 via
    modbus_tick. Remove the fast-path: the RXC ISR now only accumulates bytes and
    resets the silence countdown; modbus_tick completes the frame after t3.5 (it
    already sets frame_ready and disables RX there). Costs ~one t3.5 (~2 ms @ 19200)
    of response latency, but is spec-correct, and a byte arriving within the window
    correctly ke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
2026-06-09 perf(modbus): defer CRC to the silence timeout, shrink the RX ISR
    With frame completion now gated on the 3.5-char silence timeout, the running
    CRC computed per-byte in the USART0_RXC ISR has no remaining consumer mid-stream
    (the old fast-path that checked it on the last byte is gone) — rx_crc is read
    only once, at the timeout. So drop the per-byte CRC update from the hot RX ISR
    and compute it in one pass via crc16(buf, rx_sz) in frame_is_valid() when the
    frame is declared complete. The RX ISR is now pure byte capture (better margin
    against RX-FIFO overrun — the original starvation failure mode); the one-shot
    CRC runs at the timeout when the bus is idle, so it can't drop an incoming byte.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
2026-06-09 refactor(modbus): move frame validation out of the ISR into the main loop
    Complete the "ISRs capture, main loop validates" separation. modbus_tick (which
    runs in the TCA0 timebase ISR that also drives DALI bit timing) no longer calls
    frame_is_valid()/computes CRC or counts errors — at the t3.5 boundary it just
    sets frame_ready and freezes the RX buffer. modbus_process (main loop) now does
    the CRC + length/address validation, drops invalid/foreign-slave frames (with the
    same "real CRC failure only" error counting), and processes valid ones. No
    CRC/validation work runs in any ISR now; the timebase ISR can't be perturbed by a
    Modbus frame completing during a DALI operation.
    Validated on the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
2026-06-09 fix(dali): chunk full-mode cache wipe so RX FIFO can drain
    The full-commissioning cache wipe cleared all 64 ballasts under one
    ATOMIC_BLOCK, holding global interrupts off for the whole sweep. At 10 MHz
    that window is long enough to overrun the USART's 2-byte RX FIFO and drop an
    inbound Modbus byte — the same class as the 2026-06-05 RX-starvation bug.
    Move the ATOMIC_BLOCK inside the per-ballast loop so interrupts re-enable
    between iterations and the LVL0 USART RX ISR can drain the FIFO. The LVL1 DALI
    completion ISR (the only other writer of the ballast regs/sync_flags) stays
    fenced for the whole sweep via TCB0.INTCTRL=0, and status=0x01XX ("running")
    is already published, so a partially w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
2026-06-15 perf(dali): classify single raw command by code (no-reply -> KIND_CMD)
    OP_RAW issued every single raw command as DALI_KIND_QUERY, so the gateway armed
    the ~22 TE (~9 ms) backward-frame window even for commands that never reply
    (OFF/UP/DOWN/GOTO/STEP). That dead wait kept the single raw slot PENDING longer,
    so a back-to-back RAW_CMD — e.g. a second person's fade on the same gateway —
    got DEVICE_BUSY for longer and the controller burned more retry round-trips.
    Classify by the DALI command instead:
    - twice (rc_lo >= 2): KIND_TWICE, unchanged.
    - single, reply expected: KIND_QUERY. A reply can come back for standard
    QUERY/READ opcodes (all >= 0x90) and for special commands (odd addr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
2026-06-17 fix(dali): scan reads live level too; add sysinfo registers
    Root cause of "ballast shows 0 brightness while physically ON after a
    gateway reboot": the boot scan and SCAN_TRIGGER armed only the config-field
    scan, which never reads the live arc level, so regs_init()'s zeroed
    brightness stood until a command or the slow ~per-64s periodic re-poll
    cursor happened to touch the ballast.
    - Rename SYNC_READ_FULL -> SYNC_READ_SETTINGS (it only fetches the 7 config
    fields, not the live level) and document that it must be paired with
    SYNC_READ_LEVEL to refresh brightness.
    - Boot scan (main.c) and SCAN_TRIGGER (0x1010) now arm both
    SYNC_READ_SETTINGS | SYNC_READ_LEVEL, so a freshly-booted or resca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
2026-06-17 Switched to buck converter for power so that we can run effectively off 12V
2026-06-19 docs: lock verified LCSC part numbers into power-supply BOM
    Fill the power-supply BOM table with the final, MCP-verified, in-stock LCSC
    codes matching the KiCad PCB (BOM-MikroeAdapter.csv): MP2331H buck C6992878,
    SS34 C8678, SMBJ13A C19077567, FNR4030 4.7µH C167874, 3× 22µF/25V/1210
    C2918511 (Cin+Cout merged), 0.1µF C1525, 1µF C15849, 20Ω C5140751,
    40.2k C25893, 7.68k C25919, 10pF C0G C32949. Note U1 low stock (~29) +
    MP2315 fallback, the 25V (not 50V) Cin derating, and the R4 array→single fix.
2026-07-25 feat(clock): 20 MHz core on 5 V board rev via BOARD_5V build switch
    Add a BOARD_5V Makefile switch that derives F_CPU and passes -DBOARD_5V into
    the build. BOARD_5V=1 (default, 5 V synchronous-buck rev): run the 20 MHz
    internal oscillator undivided (MCLKCTRLB=0) and raise the BOD fuse to
    BODLEVEL7 (~4.2 V), required because 20 MHz needs V_DD >= 4.5 V. BOARD_5V=0
    keeps the legacy 3.3 V board building unchanged: 20 MHz osc divided to 10 MHz
    and BODLEVEL2 (2.6 V). Clock divider and BOD fuse in main.c are gated on the
    flag so both configs build and are functionally correct.
    Claude-Session: https://claude.ai/code/session_01Qx6PYci78VgBNLL3oD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
2026-07-25 fix(modbus): select OSC20ERR5V trim on the 5 V board rev
    baud_reg_for() applies the factory oscillator-error trim to the USART divisor.
    The correction follows the supply RAIL, not the clock divider or F_CPU (the ÷2
    prescaler is exact), so at 5 V it must use SIGROW.OSC20ERR5V instead of
    OSC20ERR3V. Gate the selection on BOARD_5V and rewrite the comment block to
    explain the rail-vs-clock distinction.
    Also (dali_state_receiving.c, comment-only): annotate the DALI RX TCB0.CNT=73
    pre-bias as a CPU-cycle-count constant. It compensates the PORT-ISR-entry +
    path-to-software-enable latency, which is itself cycle-bound, so it stays valid
    at 20 MHz (TCB0 counts at CLKDIV1 = F_CPU) — bench-verify, d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
2026-07-26 Task 04 gateway: 8-deep FC23 command queue + config-bank retirement
    Replace the single-slot raw DALI channel with an 8-deep, id-tagged command
    queue fed by a 4-command submit window and read back through a result ring
    + status block, with FC23 (0x17) so submit and collect ride one transaction.
    Queue (dali_sync.c/.h):
    - gwq[8] FIFO of 4-byte records [addr|data|idflags|dtr0]; result ring
    gwq_ring[8] ([result|answer], slot = id & 7); status ids accepted/
    executing/completed. Record reg1 packs [id:5 | flags:3 | dtr0:8]
    (id 1..31, 0 = reserved legacy/internal; flags QF_TWICE/DTR0/ANSWER).
    - gwq_submit() all-or-nothing enqueue; gwq_free_slots(); gwq_read_status()
    (TCB0+ATOMIC fenced again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
2026-07-26 Task 04: delete legacy raw path + relocate register map (round 0x1000 base)
    User directives (2026-07-26): "strip out the legacy system" and "round base,
    one number space".
    Legacy raw channel REMOVED entirely (no compat/deprecation):
    - Drop 0x1000/0x1001 RAW_CMD registers, the FC04 0x0108 raw_cmd_result (and its
    field in register_map_t), the RAW_RESULT_* macros, dali_sync_arm_raw, the
    OP_RAW id-0 mirror branch, and the FC10 raw-arm pre-flight. All commands now
    carry a controller id 1..31 and land in the result ring; id 0 is a pure
    sentinel that never enters the queue.
    Register map relocated to a round 0x1000 base, one number space:
    - Submit window QCMD[0..3] -> 0x1000-0x1007 (reusin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
2026-07-26 Task 04 docs: relocate gateway README to the new register map, drop legacy section
    Match the code: submit window 0x1000-0x1007, status block 0x1010-0x1019 (served
    under both FC03 and FC04), action/config registers 0x1F00+ (scan/rescan/slave/
    baud/commission/reset). Replace the "Legacy raw command channel" section with a
    one-line changelog note (old 0x1000/0x1001/0x0108 removed; matched firmware set,
    deploy controller+gateway together) and fold the obsolete raw-result-encoding
    bullets into a single superseding task-04 breaking-changes entry. Document the
    result-ring ordering guarantee (ring slot written before completed_id advances).
    Cla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
2026-07-26 Task 04 review fixes (gateway): correct stale addresses in docs/comments
    reviewer-04 findings 1-2:
    1. README FC-code summary table listed retired/removed surfaces (FC03 "gateway
    config", FC04 "legacy raw-command result", FC06 "legacy raw command / config").
    Rewrite the 3 rows to the current surface (level cache / group masks / queue
    status block / USERROW config; drop legacy + gateway-config mentions).
    2. dali_sync.c "Raw command queue" module comment gave wrong addresses (fed by
    "legacy 0x1000/0x1001"; status "FC04 0x0400 / holding 0x1180"). Fix to: fed by
    the submit window 0x1000-0x1007; status block 0x1010-0x1019 (FC03+FC04).
    Comment/doc only — binary unchanged (5V 15562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
2026-07-27 Task 06 stage 2a: generic mbq_slots module (gateway, unwired)
    Adds the DALI-AGNOSTIC generic slot command-queue for queue v2 — the gateway
    half of the "generic Modbus command-queue + payload adapter" split. mbq_slots
    owns 8 self-describing slots (idle/pending/executing/complete/failed), an opaque
    4-byte command per slot, [status:8|response8:8] status regs, a wrap-aware
    slave-assigned accept-sequence, all-or-nothing reject-write-to-active, and the
    load-bearing ordering (mbq_complete writes response8 BEFORE status; mbq_read_status
    reads each slot's 16-bit reg atomically under ATOMIC_BLOCK). Zero DALI: opaque
    command in, opaque response8/status out — payload meaning is the adapter's.
    Names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
2026-07-27 Task 06 stage 2b: gateway queue v2 — delete v1 ledger, wire mbq_slots
    Swaps the gateway from the task-04 id-ledger queue to the queue-v2 self-describing
    slot protocol. dali_sync.c is now the DALI ADAPTER for the generic mbq_slots queue:
    - DELETED the v1 protocol: gwq[] ring, gwq_head/count, gwq_ring, the
    q_accepted/executing/completed_id counters, and gwq_push_locked / gwq_free_slots /
    gwq_submit / gwq_read_status (~130 LOC). No id ledger, no id&7 hashing.
    - REWIRED the OP_RAW arms onto mbq_slots: pick_work executes mbq_next_pending()'s
    lowest-accept-seq pending slot (mbq_begin → EXECUTING, copies the opaque command);
    dispatch unpacks [addr,data,flags,dtr0] and issues the DALI f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
2026-07-27 task 06 stage 5: gateway macro rename + README queue-v2 rewrite
    Cosmetic macro rename (register semantics unchanged) so the names describe the
    v2 self-describing slot protocol rather than the retired v1 QSTAT/QPROG/QRES
    status words:
    MBREG_QCMD_BASE -> MBREG_SLOT_CMD_BASE (+ _END)
    MBREG_QSTAT_BASE -> MBREG_SLOT_STATUS_BASE (+ _END)
    Applied across registers.h/registers.c/modbus.c; no behavioural change.
    README: rewrite the "Raw Command Queue" section and the FC03/FC04 register-map
    entries for queue v2 (8 self-describing slots, no id/result-ring; command block
    0x1000-0x100F, per-slot status 0x1010-0x1017 = [status:8|response8:8], all-or-
    nothing reject-active write, "idle means gone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
2026-07-27 task 06 stage 5: fix stale FC04 comment (0x1010-0x1019 → 0x1010-0x1017, 8 slots)
    Claude-Session: https://claude.ai/code/session_01Qx6PYci78VgBNLL3oDM6uq
2026-07-28 Task 05: strip the gateway to a stateless DALI pipe
    The gateway no longer caches anything about the bus. Everything it used to
    know, the controller now learns by querying the ballasts through the command
    queue, so a gateway reboot is consequence-free — there is no state left to
    lose. That is what makes the original group-toggle failure structurally
    impossible rather than merely mitigated.
    DELETED:
    - g_regs entirely. Its only fields were block0 (arc/status), present[],
    dirty[] and group_mask[] — the gateway's cache of the bus.
    - dali_sync.c's brain: the sync-flag work selector, per-ballast cache,
    presence/dirty marking, group-mask diff + ADD/REMOVE fan-out, the periodic
    rescan curs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
2026-07-28 Task 05 docs: gateway README rewritten for the stateless pipe
    The README still described the firmware it stopped being: a flag-driven
    reconciliation loop with a per-ballast cache, presence/dirty bitmaps, group
    masks, a priority work selector, a periodic rescan cursor and a commissioning
    state machine. All of that is gone.
    - Opens with the architectural statement the task asked for — the gateway
    caches NOTHING, and what that buys: consequence-free reboots, board
    replacement that loses nothing, and removed addresses failing loudly rather
    than returning plausible zeros.
    - Architectural Model rewritten as the queue executor it now is, with the
    slot lifecycle, accept-order execution, m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
2026-07-29 Remove strip leftovers: dead typedef and comments describing deleted subsystems
    Spotted by Bruce reading registers.h: ballast_bs_t was still declared. It was
    the element type of block0[64] — the array went with the strip, the typedef did
    not. Declaration only, zero uses.
    The comment block above it was worse: it still documented the ENTIRE deleted
    register map (block0, group_mask, present[], dirty[]) as though those addresses
    worked, plus a controller-first rollout note two tasks stale. A header that
    describes registers which now return ILLEGAL DATA ADDRESS is worse than no
    documentation — someone would write a client against it.
    Swept the rest of the same cut while I was there:
    - main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
2026-07-29 Gateway cleanup: typed queue entries, authoritative register map, dead code
    Review pass over the whole firmware after the task-05 strip.
    TYPED QUEUE ENTRIES (both layers). The DALI adapter reached into the opaque
    command by magic index — s_raw_cmd[2] for flags, [3] for dtr0 — which is
    exactly the shape of the bug that once made a submit declare twice its length
    and arm the following slot with adjacent memory as a live DALI frame. Now:
    mbq_slots.h mbq_cmd_t typed wrapper for the opaque bytes. Carries
    no meaning — the point is that a bare
    uint8_t* can no longer be confused with a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
2026-07-29 A queue entry is now a struct, not four parallel arrays
    Bruce asked where the sequence is stored and why the command was still a byte
    array. Two different answers, and the second exposed a real gap.
    The command IS opaque at the generic layer — that layer copies the 4 bytes and
    never inspects them; interpretation belongs to the DALI adapter (dali_frame_t).
    That part was right. But what I had added was a wrapper for the command
    PAYLOAD, while the queue ENTRY — {cmd, status, response8, seq} — had no type at
    all. It was four parallel byte arrays.
    Now mbq_slot_t, with the sequence documented where it belongs: stamped by the
    GATEWAY at idle->pending, execution is lowest-seq-first and wrap-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
2026-07-29 mbq: embed the status pair in the slot; make MBQ_CMD_REGS load-bearing
    The previous commit introduced two declarations that nothing used, in a
    change whose purpose was removing dead code:
    - mbq_slot_status_t declared the [status | response8] wire pair, while
    mbq_slot_t separately repeated both fields. Two definitions of one
    layout, free to drift.
    - MBQ_CMD_REGS documented that a submit's length is in REGISTERS — the
    units confusion behind the two-slot bug — while modbus.c went on
    deriving first_slot and n_slots from a literal 2.
    Fix both by use rather than deletion. mbq_slot_t now embeds
    mbq_slot_status_t as `st`, so the in-memory and wire layouts cannot
    disagree, a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
2026-07-29 errors: one error enum, and no failure that vanishes
    Review of the firmware's error handling, prompted by the `if (slot >=
    MBQ_SLOTS) return;` guards in mbq_slots.c silently doing nothing.
    The worst offender was not those guards but regs_write_holding, which
    collapsed FIVE distinct causes into one `false`: an out-of-range baud
    index, a bad slave address, a wrong reset magic, a failed NVM write and a
    genuinely unmapped address. The master was told ILLEGAL_ADDRESS ("no such
    register") for all five, so writing baud=5 reported that 0x1F03 does not
    exist — wrong, and undiagnosable from the far end of an RS-485 bus.
    New src/errors.h defines tm_err_t (OK, NO_SUCH_REG, BAD_VALUE, BAD_RANGE,
    BUSY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
2026-07-29 dali_sync: the command IS the state; keep only which step we are on
    types.h is gone and the parallel copy of the command with it.
    You were right that dali_kind_t, addr and data all duplicate what the
    queued command already says. Every field of the old per-send struct was
    derivable from the 4-byte command plus the step:
    addr/data a DTR0 preload sends (0xA3, dtr0); any frame step sends the
    command's own two bytes.
    kind QF_TWICE / QF_ANSWER / neither — and a preload is never a
    query regardless of what the frame after it is.
    repeat a send-twice is two sends by definition, so the countdown
    was only ever "which of the two is this" — i.e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
2026-07-29 sysinfo: give the boot diagnostics their own module
    g_uptime_s had nothing to do with DALI. It was defined in dali_sync.c and
    declared in dali_sync.h only because the RTC PIT that maintains it also
    drove a DALI rescan cursor — which became the controller's job in task 05,
    leaving the counter as a guest of a subsystem with no claim on it.
    Pulling that thread found the same smell twice more: g_boot_count and
    g_reset_reason were defined in main.c but declared in registers.h, which
    is the Modbus register map and owns neither. registers.h even carried a
    comment pointing readers at dali_sync.{c,h} for the third value.
    All three serve one thing — the FC04 sysinfo block — and all three are
    p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
2026-07-29 dali: name the two flags for their layers; they are not inverses
    dali_idle and dali_busy read as one flag written twice. They are two
    different layers, and the pairing of "idle" with "busy" actively invited
    the wrong reading:
    dali_idle -> dali_line_idle (dali.h, bit-level): the state machine is
    PARKED — TX released, receiver armed, rising-edge monitor
    watching for another master. A statement about the WIRE.
    dali_busy -> dali_cmd_active (dali_sync.h, issuance): a queue slot is
    CLAIMED, held across the whole multi-frame sequence (DTR0
    preload + frame + send-twice repeat) so nothing interleaves
    within on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
2026-07-29 dali: dali_cmd_executing — name it for the lifecycle state it mirrors
    You are right that dali_cmd_active was still ambiguous, but not that the
    answer is pending_cmd_in_queue — that name would collide with the queue's
    existing vocabulary and describe the wrong half of the lifecycle.
    mbq_slots.h already defines MBQ_S_PENDING as "accepted, waiting to
    execute" and MBQ_S_EXECUTING as "in flight". This flag rises when
    mbq_begin() marks a slot MBQ_S_EXECUTING and falls when that slot goes
    terminal. So it tracks EXECUTING exactly — and PENDING is precisely the
    state BEFORE it rises. Calling it "pending" would name the state the flag
    is false during.
    "in queue" is a different question again,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
2026-07-29 dali: one channel state, three values, illegal fourth unrepresentable
    Answering both questions together, because they have the same answer.
    "How is dali_cmd_executing different to dali_busy — the bus can only be
    busy if it is executing a command?" It cannot only be that. The bus is
    busy whenever ANOTHER master is sending, and this firmware handles that
    explicitly: external_message_started fires on a rising edge while we are
    parked, and we yield owning nothing at all. A stuck or shorted bus is the
    same shape. "Is the wire asserted right now" is a third condition
    entirely, answered by dali_is_bus_active(), which reads the RX pin. That
    ambiguity is exactly what made "busy" the wrong word —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
2026-07-29 dali: say what actually triggers the yield, not just "another master"
    You are right that a second master is extremely unlikely here, and that
    lowers the practical risk of the one path the bench cannot exercise. But
    my caveat framed it wrongly, in a way that could cost us later.
    The rising-edge monitor armed while PARKED cannot tell what pulled the
    line. On a single-master bus the same edge is produced by a ballast
    answering late (a backward frame after our response window closed), by
    noise or reflections on a long run, and by the bus being held asserted by
    a short or a sagging supply — that last one being exactly what the 200 TE
    escape in dali_state_wait_for_idle.c exists to recover from,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
2026-07-29 dali: one slot scan per loop, not two
    start_next_dali_work() called mbq_next_pending(), then main() turned round
    and called mbq_has_work() — two walks of the same 8-slot array on every
    iteration of the main loop, asking overlapping questions about it.
    start_next_dali_work() now returns whether any DALI work is OUTSTANDING
    rather than whether it happened to launch something. Nothing consumed the
    old return value (main() discarded it), so the meaning was free to change.
    The merge is better than it first looks, because the two early exits answer
    the question WITHOUT scanning at all:
    own a command already -> outstanding, no scan needed
    bus not free -> outstanding, no scan neede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
2026-07-29 mbq: drop the fences the write order already covers
    You were right about the queue. Both ATOMIC_BLOCKs in mbq_slots.c are
    removed; the one in dali_sync.c stays, because it guards something else
    entirely.
    The only concurrent writer to the slots is mbq_complete, in the LVL1 DALI
    completion ISR, touching just the one EXECUTING slot. mbq_submit,
    mbq_read_status, mbq_begin and mbq_next_pending are all main context, so
    they cannot race each other.
    mbq_read_status: the ORDER is the invariant, not the fence.
    writer: response8, THEN status
    reader: status, THEN response8
    If a reader observes a terminal status, the ISR had already written status
    — which happens after response8 — so the res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
2026-08-04 docs: describe what the gateway IS; move the history to DESIGN-HISTORY.md
    The source and README carried a running commentary on what the firmware used
    to be — task numbers, "this used to be", "retired in task 04", a Behavioural
    Changes changelog. Useful while the refactor was in flight, noise now: a
    reader wanting to know how the gateway works had to filter out how it used to
    work.
    All of it moved to DESIGN-HISTORY.md, which states up front that nothing in
    it is current and that the code wins any disagreement. It covers the gateway
    as brain before the strip and what went where, the removed register ranges,
    the v1 id-ledger queue and why it was replaced, the representations that were
    dupli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
2026-08-05 docs: registers.h lists only registers that exist; trim CLAUDE.md
    registers.h still carried a table of addresses that are NOT served — the
    old cache banks, presence/dirty bitmaps, group masks, scan trigger, rescan
    interval, commission register. Enumerating them made the map look larger
    than it is, and the rule above the table already covers them: anything not
    listed returns ILLEGAL DATA ADDRESS. Gone; DESIGN-HISTORY.md has the list
    for anyone decoding an old client.
    An earlier edit of mine had also left the block mangled — "The gateway
    caches nothing about / of the bus; it now caches nothing" — which is what
    made it visible. Fixed rather than papered over.
    Same treatment in registers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
2026-08-09 mbq: two slots — EXECUTING and NEXT
    The 8-slot queue was buying buffering the DALI bus cannot use: it runs
    one frame at a time, so slots 2..7 only ever sat idle. They were not
    free, though — the master reads the WHOLE status block on every submit
    and every poll, so at 19200 each transaction carried a 21-byte reply
    (10.9 ms) where 9 bytes (4.7 ms) would do, whether or not anything had
    changed. Measured on the bench, that reply was the single largest
    component of a 25.1 ms transaction, and one saturated gateway consumed
    99% of the RS-485 bus.
    Two slots is all a one-frame-at-a-time bus can use: one EXECUTING, one
    staged NEXT. The only requirement is that the master refill the freed
    slot wi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
2026-08-09 mbq: three slots, and a spec-conformant t3.5 at 38400
    THREE slots, not two. A submit carries its own status read-back, so at
    the instant the master issues one it must ALREADY know a slot is free —
    and that knowledge is one round trip old. With two slots both are
    occupied in steady state, so the master must spend a read-only poll to
    discover a completion before it can write. Measured on the bench: 2.06
    Modbus transactions per DALI frame at two slots against 1.38 at eight,
    which made two slots ~9% SLOWER (27.3 vs 30.1 DALI frames/s) even though
    each transaction was 28% cheaper. Three restores one transaction per
    frame while keeping the status reply at 6 payload bytes instead of 16.
    The mast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
2026-08-09 mbq: FC65/FC66 — let the GATEWAY pick the slot
    FC23 makes the master name the register it writes to, so it may only
    submit into a slot it ALREADY knows is free — and it learns that only
    from a previous read. That forces a read-only poll that carries no work
    before every submit. Measured on the bench: 2.04 Modbus transactions per
    DALI frame where 1.0 should do, at every slot count from 2 to 3. Eight
    slots only did better (1.38) because a deeper queue lets one poll reveal
    several completions at once, amortising it — not because the poll went
    away.
    FC65 removes the dependency: "enqueue this command wherever you have
    room, and tell me the whole status block." The gateway chooses, so the
    m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
2026-08-09 docs: write the queue protocol contract for review
    Byte-exact packet layouts for FC23/FC65/FC66, the slot state machine,
    the command payload, the full steady-state cycle side by side with
    FC23, capability negotiation, and the measured/projected byte costs.
    Written to be analysed before the controller client is switched over —
    the FC65 semantics differ from FC23 in one way that is easy to miss and
    expensive to get wrong: the gateway snapshots the status block BEFORE
    enqueuing, so accepted_slot's entry describes the PREVIOUS occupant, not
    the command just sent. Open questions are listed rather than decided.
2026-08-09 docs: add command tagging to the queue contract
    The FC65 draft had no identity on the wire, which the slot index gave
    FC23 for free. The gateway's internal seq field is not identity — it is
    an accept-sequence for execution ordering only, valid while PENDING, and
    never transmitted.
    Without a tag, a lost reply leaves the master unable to answer 'did my
    command land, and where?'. Both available actions are wrong: resend and
    a QF_TWICE SET-class command may execute twice; don't resend and it may
    never execute. FC23 avoided this because the master chose the slot and
    could inspect it — that is what SLOT_SENT/SLOT_LIVE and
    resolve_ambiguous() are for.
    FC65 now carries a master-chosen 8-bit ta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
2026-08-09 docs: flag that the queue contract describes the tagged design, not the code
    The committed FC65 draft (da757d8, and controller 5880294) is the
    UNTAGGED protocol: 8-byte request, no tag, accepted_slot=0xFF for a full
    queue. The document was redesigned around command tagging after review
    and now describes something no code implements.
    Nothing on a device is affected — mbq_client still drives the queue
    purely over FC23, so FC65 is unreachable in running firmware — but the
    source and the document would mislead anyone reading them together.
    Banner states which is which until the client work reconciles them.
2026-08-09 docs: identity from the gateway's own sequence, not a master tag
    Reverts the master-supplied tag. The queue already had a slave-decided
    accept sequence (mbq_slot_t.seq) — stamped by the gateway at enqueue and
    used by mbq_next_pending() to run commands in submission order. It was
    simply never transmitted, while the wire status byte spent all 8 bits on
    an enum with 5 values.
    Packing the status byte [state:3 | seq:5] puts identity in bytes already
    being sent:
    - request drops back to 8 bytes (no tag)
    - accepted_slot becomes redundant — the status block says which slot
    holds which sequence, which is strictly more information — so the
    reply drops to 10 bytes, one BELOW the firs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
2026-08-09 docs: write-then-read, with a reported bit; drop the status banner
    Two changes.
    1) Removed the implementation-status banner. Not wanted in the contract.
    2) FC65 is now write-then-read, as it should have been: place the
    command, then build the reply from the status block as it stands. The
    reply shows the command just sent — PENDING, or EXECUTING if the arbiter
    took it first — so the master gets its (slot, seq) binding from the
    transaction that created it, instead of one transaction later.
    The reason the earlier draft read first was that reusing a terminal slot
    destroys a result the master has not seen. Write-then-read alone does
    NOT fix that, and my first sketch of it was wrong in a wa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
2026-08-09 docs: queue v3 — displacement + persistent displaced register + boot epoch
    Supersedes the draft-2 reported-bit design, which its own walkthrough showed
    alternating report/place at saturation (2 txns/frame — what FC23 already
    costs) and which still had one lossy terminal path.
    - Enqueue may displace the oldest terminal immediately; its result rides the
    same reply AND persists in a 1-entry displaced register until the next
    enqueue, so a lost reply can never lose a result. One txn per DALI frame
    at 3 slots, no 4th slot, no reported bit.
    - boot8 (boot-count low byte) in every reply: reboot detection by comparison,
    replacing the 'idle means gone' inference and its double-execution co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
2026-08-09 docs: correct the flash-budget claim; real headroom is 5.3 KB
    Task 05's strip left far more room than the task-04-era ~800 B figure. FC23
    removal stands on matched-set deploys and one-path-to-test, not flash
    pressure. Records the measured baseline (11028/16384 flash, 137/1024 RAM).
    Claude-Session: https://claude.ai/code/session_01STSZT2DguJ8ntaDTJXvk1d
2026-08-09 G1: queue v4 core — cq.{c,h} replaces the v2 slot queue
    Two queues per QUEUE-PROTOCOL.md v4: a strict-FIFO command queue (CMDQ_DEPTH=2,
    a build-time constant the wire knows nothing about) and a response queue
    (RESPQ_DEPTH=4) whose results are retained until the master acks them. Command
    lifecycle is FREE/PENDING/EXECUTING and nothing else — a finished command is not
    a slot in a terminal state, it is a response entry plus a freed slot, which is
    what removes the extra poll per DALI frame the v2 model forced.
    Two invariants are load-bearing and are documented as such in cq.h:
    Backpressure — cq_next() refuses to start a command unless the response queue
    has a free entry, so a full re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
2026-08-09 spec: fix an ambiguity in the lost-reply recovery rules (R1 vs R3)
    R1 and R3 could match the SAME observation and disagree, which is the
    result-misattribution class task 04 spent three cycles on:
    - 'head advanced past the acked seq' was loose. Exact test is 'head no
    longer HOLDS the acked seq' — the ack applying is what proves the frame
    landed, since ack and enqueue travel in one frame.
    - An EMPTY head after a lost reply is genuinely ambiguous (ack applied and
    the queue drained vs a reboot wiped it). R3 as written claimed reboot;
    R1 as written claimed landed. Resolved with an explicit evaluation order
    and a cold-path boot_count read for that one branch.
    - R3's 'head empty' test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
2026-08-09 spec: close the controller-reboot false-R3, and pin where the prediction comes from
    Three gaps found stress-testing §4:
    - A command still executing when the CONTROLLER dies pushes its result
    AFTER a single drain pass. The fresh controller, tracking nothing, reads
    it as an untracked seq and fires R3 — a gateway reboot that never
    happened. Fix: drain, wait one RESULT_DEADLINE_MS, drain again. Bounded
    because the gateway holds at most CMDQ_DEPTH commands.
    - The predicted seq must come from the last OBSERVED accept, not a local
    counter. That makes an unnoticed reboot self-correcting instead of a
    latent mis-binding.
    - States that an undetected reboot (nothing in flight, nothing un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
2026-08-09 spec: re-base the duty projection on measured per-transaction cost
    A byte count overstates the win. Measured FC23 on this rig: 19.46 ms
    charged per transaction for 14.58 ms of wire — ~4.9 ms is FIXED cost
    (gateway turnaround, t3.5, master SM) and does not shrink with the frame.
    So a v4 enqueue costs ~12.2 ms charged, not 7.3. Revised projection:
    ~34% bus on the soak mix (not 27%), ~49% all-SET, and two saturated
    gateways are workable on realistic traffic but MARGINAL on pure SET
    streams. Still 2.8x better than the measured 99% FC23 baseline.
    Gates V1/V6 re-stated against measured numbers: txns-per-command 1.73 ->
    ~1.0, pair rate >= 14.71/s, bus ~34% (pass under ~45%). Notes that the
    fixe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
2026-08-09 G2: FC 0x41 handler; retire FC23, the draft FC65/66 and the 0x1000/0x1010 ranges
    One user-defined function code now carries all queue traffic. A request
    optionally enqueues one command and optionally acks the head of the response
    queue; the reply reports the fate of the enqueue plus the current head. Three
    request shapes (5/7/8 bytes) and two reply shapes (6/7 bytes), per
    QUEUE-PROTOCOL.md §1.
    Processing order is ack -> enqueue -> build reply, and the comment says why it
    is the protocol rather than an implementation detail: acking first is what frees
    a response entry in time for the backpressure rule to use it in the SAME
    transaction. Reversed, it costs a whole transaction per DALI frame a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
2026-08-09 G3: DALI adapter onto the v4 queue hooks
    cq_next/cq_begin/cq_complete in place of the slot API. The adapter now tracks
    the command's SEQ alongside the queue index and reports completion against the
    seq, not the index: a seq names one command for its whole life where an index
    names a reusable slot, so a completion can never be attributed to whatever was
    enqueued after it.
    Outcome mapping is unchanged in substance (OK -> answer byte, NAK/MALFORMED/
    other -> the three DALI failure codes), retargeted from MBQ_S_COMPLETE/FAILED
    onto H_OK/H_FAILED.
    The QF_* flag bits and dali_frame_of() did NOT change, which is the point of
    normalising the wire flags in the Modbus parser (G2) — the hazard call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
2026-08-09 G4: host unit test for the queue core, and the budget gate
    test/cq_test.c — the first host test in this repo. cq.c is pure C whose only
    dependency is errors.h (a type and three prototypes it never calls), so it
    compiles and runs on the host exactly as it does on the ATtiny. Nine groups,
    self-contained, non-zero exit on failure; the build line is in the file header
    per the controller's convention.
    What it covers, in the order the protocol depends on it: a full
    accept/begin/complete/head/ack cycle; H_FAILED packing; sequence assignment
    1..31 with 0 SKIPPED on wrap, swept over two full laps; command-queue-full
    returning 0 without burning a sequence number (an A_FULL that consumed a seq
    would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
2026-08-09 spec: correct the G4 RAM expectation, record the measured budget
    'RAM down ~40 B' was arithmetic against v2's original s_slot[8], which had
    already been narrowed to 3 slots — §9's table (+10 B) was right and the
    stage line was wrong. gw-coder caught the contradiction during the budget
    gate rather than quietly building to whichever number suited.
    Records the measured result: flash 11028 -> 10420 (-608), RAM 137 -> 152
    (+15). Both accepted.
    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
2026-08-09 G4b: factor out the FC 0x41 validation table, host-test it, bump to v1.0
    Three requests from the team lead and ct-coder, none of which changed any
    runtime behaviour.
    1. VALIDATION TABLE IS NOW A NAMED, TESTABLE THING. The length/flag decision
    moves out of frame_is_valid()'s switch into fc41_len_ok(len, flags) in a new
    src/fc41.h, which also becomes the single transcription of the FC 0x41 request
    and reply wire formats (lengths, QW_* wire flag bits, accept status codes). The
    header is free of AVR dependencies so the host test compiles it directly.
    This is worth doing on its own merits, not just for testability: the table is
    the security-relevant part of the parser. QW_DTR0 is what decides w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
2026-08-09 G4c: review fixes — stall counter, ISR-level contract, head-only cq_begin
    Addresses gw-reviewer's four findings. Items 1, 2 and 4 changed code; item 3 was
    already reconciled. Flash 10 424 -> 10 462 B (+38), RAM 152 -> 153 B (+1).
    1. STALL COUNTER WAS COUNTING POLLS, NOT STALLS (medium). cq_next() incremented
    `stalls` on every call that found the response queue full, and the main loop
    polls it free-running — while stalled neither of start_next_dali_work's early
    exits fires, so roughly 18 000 increments per second landed on it, wrapping the
    16-bit counter about every 3.6 s.
    The behaviour was correct; the evidence was worthless, which is the task-07
    failure shape precisely. Validation gat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
2026-08-09 spec: the pacing rule missed the case that dominates — the in-flight cap
    First v4 bench run: verdict clean, throughput fine (14.83 pairs/s vs FC23's
    14.71), bus 99% -> 67%, per-transaction cost 11.79 ms almost exactly as
    projected — and 2.04 transactions per command, WORSE than FC23's 1.73.
    749 enqueues against 773 polls, with pacing reporting 'queue full 99%'.
    Root cause is this document, not the client. §5 said to pace 'on A_FULL, or
    when awaiting results with an empty backlog'. The steady state is neither:
    it is 'at the in-flight cap with a non-empty backlog', which the wording
    never covered, so the client polled to discover completions instead of
    waiting for them.
    Restated: pace w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
2026-08-09 G4d: real `make test` target — it was a no-op that exited 0
    gw-reviewer's last finding. There was no `test` target and no `.PHONY`, so
    `make test` matched the test/ DIRECTORY, printed "Nothing to be done for
    `test'" and exited 0. Anyone running it — or any CI step shelling it — got a
    clean-looking pass having executed zero tests.
    That matters because ba15577 deliberately moved validation gate V5 off the bench
    and into this suite: the rig has no independent RS-485 master to inject
    malformed frames with, so "the host test passes" is the only evidence V5 has.
    Evidence has to be reproducible and has to fail loudly, and its only documented
    invocation was a cc line in a file comment.
    Verif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
2026-08-09 spec: status is built-and-running; pacing promoted in the decisions log
    - Status banner said NOT YET BUILT; both halves are now on the bench and
    talking. Points at the task doc for gate progress and flags §5 pacing as
    the thing to read before touching the client.
    - §0 now says the one-txn-per-frame property is conditional on the client
    waiting rather than polling, with the 2.04 measurement as the evidence.
    - Decisions log: pacing gets its own row (it was buried inside the
    starvation row as 'bus economy only', which is exactly the
    under-statement that let the client be built eagerly-polling), and the
    duplicated FC23-fallback row with the wrong flash rationale is removed.
    Co-Aut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
2026-08-09 G4e: record cq_accept's invariant break instead of reporting it as A_FULL
    gw-reviewer's late finding, via ct-reviewer's cross-half read. Two problems
    stacked on one branch — the `s_cmdq[idx].state != CQ_FREE` case in cq_accept,
    where the ring cursor and the slot's state byte disagree.
    It returned CQ_SEQ_NONE (reported as A_FULL) and bumped the a_full counter,
    recording nothing.
    VIOLATED errors.h RULE 2. That branch is by construction "an internal invariant
    has broken", and it had no caller to return to, so it must be recorded. It
    wasn't — a broken gateway invariant was indistinguishable from the bus from
    routine queue pressure.
    WORSE, IT INFLATED THE WRONG COUNTER. ba15577 redefined a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
2026-08-09 spec: status is validated, and §1 names the WIRE flags QW_*
    - Header no longer claims to contain an implementation plan, and the status
    banner says validated rather than in-progress. Points at §10 for results
    and flags the two things a reader must not miss: the pacing rule, and the
    retracted A_FULL safety claim.
    - §10 was a forward-looking build plan (stages G1-G4 / C1-C4) that the work
    has overtaken. Replaced with what the spec actually needs to carry: the
    measured results and a REGRESSION CHECKLIST, including the three traps the
    bring-up fell into — a clean verdict at 2 txns/command is a failure, a
    RESULT_LOST per reboot is correct, and busload must be read at the finish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
2026-08-09 history: record the v2 slot queue and the FC23 transport it rode on
    Queue v4 (task 08) replaces both. Captures the wire shape so an old capture
    is still readable, the measured reason it went (1.73 txns/command and 99%
    bus, against v4's 1.03 and 37%), and the retired ranges.
    Also records two things that would otherwise vanish without trace: the
    never-shipped draft FC65/FC66 that briefly used 0x41 with DIFFERENT
    semantics — so a capture showing 0x41 must be dated before it can be
    decoded — and controller/docs/modbus-command-queue.md, the standalone v2
    spec deleted in this task.
    Notes what survived: DALI-agnosticism, and the publication-ordering rule,
    which is the one invariant carried fo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
2026-08-09 test.py: probe the registers that still exist
    The scratchpad probe was reading blocks retired in TASK 05 — the presence
    and dirty bitmaps at 0x0100 and the per-ballast cache at 0x0000, both
    ILLEGAL DATA ADDRESS since the gateway stopped caching bus state. It also
    hardcoded a serial port that no longer exists and 9600 baud, where 19200 is
    canonical. Only the version read still worked.
    Now reads version, sysinfo (with reset_reason decoded), RX diagnostics
    including the internal-fault registers, and the v4 queue counters — with
    the reading guidance that matters: a_full and discards are warnings,
    stalls is not (it is the backpressure rule working, and a client honouring
    its in-flight cap ca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
2026-08-09 docs: rewrite the README's Modbus interface for queue v4
    The "Modbus Interface" section still documented the retired v2 slot protocol
    behind a temporary out-of-date banner. Replaced it with the v4 interface and
    deleted the banner.
    - Function codes: FC 0x41 is the queue; FC23 (0x17) is gone and now returns
    ILLEGAL FUNCTION.
    - Register map: the queue is no longer in it. 0x1000-0x100F and 0x1010-0x1017
    join the retired list (ILLEGAL DATA ADDRESS); new queue-counter block at
    FC04 0x0320, read exactly 8, with a note on how to read a_full (canary),
    stalls (backpressure working) and q_discard (malformed frames).
    - New "command queue" subsection: frame shapes and the length/flag validation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
2026-08-13 queue: H_NAK — a NAK is not a failure
    The gateway reported two unrelated events as H_FAILED + DALI_RESP_NAK:
    a SET-class frame that completed normally, where no backward frame was
    ever expected (finished_transmission fires DALI_RESPONSE_NAK when it
    never opened a response window at all); and
    a query that asked for an answer and heard silence.
    The first is a success. The second is a legitimate DALI outcome, not a
    breakage: IEC 62386 yes/no queries answer "no" by staying silent, which
    is exactly what the commissioning COMPARE bisect and the any-on probe
    rely on. Reporting both as failures meant the failure counters counted
    normal outcomes, and left "absent" and "said no" distingui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
2026-08-14 fix(modbus): SFDEN silicon erratum — RS-485 was corrupting its own receive
    Both bauds were losing frames, 19200 included, and the cause was a
    documented Microchip silicon erratum we were sitting squarely inside.
    Microchip tinyAVR silicon errata, USART:
    "Start-of-Frame Detector Can Be Unintentionally Triggered"
    "If the Receive Data (RXDATA) registers are read while receiving new
    data, the Receive Complete Interrupt Flag (RXCIF) is cleared. This
    triggers the Start-of-Frame Detector and falsely detects the
    following falling edge as a start bit. When the Start-of-Frame
    Detector detects a start condition, the frame reception is
    restarted, resulting in corr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
2026-08-14 38400 by default, and retire the claims this session disproved
    BAUD_INDEX defaults to 2 (38400) for `make configure`. 9600 remains the
    factory/safe speed an unprogrammed USERROW falls back to.
    ALTERNATE-QUEUE-APPROACH.md is deleted: QUEUE-PROTOCOL.md IS the answer to
    it, and keeping the proposal alongside the specification invited reading
    the wrong one as current. Its lineage is recorded in the spec's preamble.
    QUEUE-PROTOCOL.md carried three claims the code has outgrown, and the
    spec declares itself authoritative over the code ("where this document
    and the code disagree, this document is the intent and the code is the
    bug") — so stale normative text here is not cosmetic. A reader follow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
2026-08-17 defer USERROW commit off the DALI hot path
    userrow_commit()'s PAGEERASEWRITE hardware-halts the CPU for ~3.4 ms with
    every ISR frozen, and it ran synchronously inside modbus_process() on every
    slave-address/baud-index write with no check that a DALI command was
    mid-flight. TCA0_OVF bit timing (tick.c) freezes along with everything else,
    possibly with PB0 left asserted (the TCA0_OVF_vect TX backstop is itself
    frozen) — a corrupt forward frame the ballast is receiving, which is a
    double-apply risk for a non-idempotent command.
    Split the write into stage (SRAM only, in the FC06/FC10 handler, replies
    success immediately since a config write is idempotent) and commit (the
    actual flash write, n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
2026-08-17 FC10 stops answering DEVICE_BUSY for a register range that no longer exists
    The task-05 stateless-pipe strip removed group membership masks
    (0x0110-0x014F) and regs_write_holding, but a pre-flight loop in process_fc10
    was never told: it still counted registers in that dead range and answered
    MB_ERR_DEVICE_BUSY for more than one, while a single-register write to the
    same range correctly gets ILLEGAL_ADDRESS from regs_write_holding. A client
    whose "busy = retry" policy takes DEVICE_BUSY literally retries forever
    against an address that will never stop being illegal.
    Deleted the loop; the per-register loop below already answers ILLEGAL_ADDRESS
    for that range like any other unmapped register, s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
2026-08-17 diag_last_fail_len reports what's actually in the 16-byte capture
    modbus.c stored raw rx_sz (up to MAX_PKT_SZ = 40) into diag_last_fail_len
    while the frame copy right below it clamped to sizeof(diag_last_fail) = 16.
    A master decoding FC04 0x0300 reg4 as "how many frame bytes follow" would
    read up to 40 bytes out of a field that only ever holds 16, running past
    reg5-12 into reg13-14 (the fault counters) and reading them as frame data.
    Store the clamped length instead, and document reg4's cap in registers.h.
    +2 B flash (10324 -> 10326), no RAM change.
    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
2026-08-17 docs: A_FULL is flow control, not a canary — and finish a spliced sentence
    registers.h, cq.h and cq.c all still described A_FULL as unreachable and
    non-zero as a master-side accounting bug. That was the pre-queue-v4 story;
    since the v4 rework (CLAUDE.md, QUEUE-PROTOCOL.md §5) the client re-offers on
    A_FULL instead of pacing against an estimate, so a refusal means the DALI
    engine is fully fed — the goal state — and the refusal share (~72% under one
    saturated gateway) is the headroom gauge, not a fault to investigate. The one
    thing that IS still a fault is cq_accept()'s invariant-break branch, which
    deliberately does not touch the a_full counter; the rewritten comments call
    that out exp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
2026-09-30 rx diagnostics: ignore clean frames for other devices, framing errors included
    frame_error was charged per byte in the RX ISR, before anyone knew whose
    frame it was, so on a multi-drop bus a gateway logged framing errors on
    other slaves' clean traffic. The first two-gateway bench (2026-09-30) had
    the idle slave 3 reporting 988 frame errors against 1365 good frames during
    a soak on slave 2, while the controller saw zero failures.
    Framing errors are now tallied per frame (rx_ferr) and charged at the frame
    boundary. A CRC-good frame addressed to another device is ignored entirely,
    framing errors included. A CRC-bad frame is always counted, as crc_error
    already was: its address byte can't be tr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
2026-09-30 modbus: detect frame ends inside t1.5..t3.5, and hold replies past every listener
    On a multi-drop bus the idle gateway merged its neighbour's request+reply
    pairs into one frame and logged them as CRC/framing errors (first
    two-gateway bench, 2026-09-30: 254 frame / 274 CRC errors in 45 s on the
    idle slave, zero at the controller).
    Root cause: the end-of-frame silence window was sized so its LOWER bound
    met t3.5 (2026-08-09), which is the wrong bound. Detection must sit above
    t1.5 (never split a frame) and at or below t3.5 (never miss a legal
    inter-frame gap). The old windows -- 3.75-4.17 / 2.08-2.50 / 2.08-2.50 ms
    at 9600/19200/38400 -- all sat above t3.5, and a slave replying one t3.5
    after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
2026-09-30 FC04 0x0210: report the build (git describe) the image came from
    Until now nothing on the wire said which build a gateway runs -- FW_VERSION
    was passed to the compiler but never used, so two different commits
    produced byte-identical hex and a fielded gateway could only be identified
    by reading its flash back over UPDI. The version block at 0x0200 can't
    carry it: "DALI v1.0 <serial>" is 30 of its 32 bytes and its v1.0 is the
    queue-generation marker the controller's compatibility check keys on.
    New read-only block FC04 0x0210, exact-length 16 registers: the
    `git describe --long --dirty --tags` string, ASCII, NUL-padded to 32 bytes,
    stored in PROGMEM (flash +112 B, RAM unchanged). "-dirty" = b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
2026-10-04 gateway: glued frame pairs aren't errors; a garbled reply is a collision
    Two fixes found on the house bus, batched for one panel visit.
    1. A slave that answers faster than our end-of-frame window leaves no gap we
    can see, so the master's request and its reply arrive as one capture and
    its CRC fails. The house relay board (slave 1) does this on every coil
    poll: both gateways logged `01 01 00 00 00 20 3d d2 | 01 01 04 ...` as a
    CRC error, ~one per poll, on a healthy bus. frame_is_pair() (new pure
    module) checks whether a CRC-bad capture splits into two frames that each
    pass their own CRC; if so and neither half is addressed to us, it is
    ignored like any other foreign traf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
